glucoboy/DroneAgricole/configs/README.md

# Configurations

Paramètres partagés, profils de plateforme, calibrations de référence non sensibles et configurations de campagne.

Chaque configuration critique doit être liée à une version de matériel et porter des unités explicites.
