glucoboy/DroneAgricole/hardware/cad/cartographe_v0_1/empreintes_sources.csv

fichier | octets | sha256
Airy_3D_FOV.STEP | 8741607 | 62BF7D54AB7475F72D09EAFF1B641E6A658C45FAE5A42977667CD1F92E418BE3
Basler_ace_2_USB3.zip | 2178520 | D7F824E735B549A6CDD761DCA437656FBA1712C78CD92BFE94A426819BFCA4F4
basler_dimensions.svg | 24594 | A97F470CA227974FC0EEC72EC5B8B4EC3C7F0A1F28764435E732E62D50F45518
jetson_orin_nano_devkit.zip | 12998544 | 9F00FF9B7FC36265842E6463BEE6954350C461D4B0CD52C87AEF3872BAF8FE1C
pixhawk_5x_6x_module.stp | 1000676 | 6E0AA698FDCD1565BDC3709B92054BE0DC55AA82D951FE10B6F5B554210A477C
pixhawk6x_base_v2a.stp | 39520842 | 0610FA7762F88B5EB867647702C6A34BD2F6FE98FF04C158EFB860AD077AC11C
simpleRTK2B_PCB.PDF | 77293 | 57E04ACBD0D91F22E6FE09BE9FFCDD2ABE6DAFC2EC8DB6D04C977B0DF89C1A38
simpleRTK2B.STL | 3617784 | CD550B324E5070A756FBC59C7BB1A22EE38B8263B5B4434B89BD80D70E189C4D
x650-frame-2025-0825.stp | 25393107 | 62CF031A85C59A7F023C2B525115497DFB0821DE9C964C1A5CF905C549D156F7
basler/Basler ace 2 USB3.pdf | 192614 | E16CD2B1CA47EC81D0DC8EA953976592B4D870148079B5FCC45D91605CE7977F
basler/Basler ace 2 USB3.stp | 17116645 | C71E32C1FADA09C6EEF04587602841991BC90B03944DB6FDBA84754055CFB901
jetson/P3766-P3768SKU4-P3767ENVELOPE.stp | 74004141 | 02DAFEF626D5AC6EE029D1EAD431D6096C27C7C51FEF6B49D5189E1765FB9D2F
