glucoboy/DroneAgricole/datasets/README.md

# Datasets

Les données volumineuses ne sont pas ajoutées à Git. Seuls les manifestes, licences, checksums, adaptateurs et instructions de téléchargement sont versionnés.

Organisation prévue :

```text
datasets/
├── manifests/
├── public/
├── recorded/
└── cache/
```

Chaque dataset doit documenter sa source, sa licence, ses capteurs, ses repères, ses timestamps, ses calibrations, sa vérité terrain et son checksum.
