glucoboy/DroneAgricole/research/README.md

# Recherche

Études comparatives, notes bibliographiques, état de l'art, brevets, réglementation et résultats exploratoires.

Chaque note doit distinguer clairement faits sourcés, hypothèses de conception et décisions du projet.
