glucoboy/DroneAgricole/docs/decisions/README.md

# Décisions d'architecture (ADR)

Chaque décision structurante est décrite dans un fichier numéroté :

```text
ADR-0001-titre-court.md
```

Le document précise le contexte, la décision, les alternatives, les conséquences et le statut. Les décisions pressenties dans les documents préliminaires ne deviennent définitives qu'après validation ou création d'un ADR accepté.

## Registre

| Référence | Décision | Statut |
|---|---|---|
| ADR-0001 | Sélection initiale des datasets | accepté pour le premier benchmark |
| ADR-0002 | Séparation des environnements ROS, simulation et LIO | accepté pour le premier socle |
| ADR-0003 | Interface PX4–ROS 2 par uXRCE-DDS | accepté pour le lot A expérimental |
| ADR-0004 | Répartition des calculs entre drones et station | accepté |
| ADR-0005 | Tableau de bord comme plan de contrôle des simulations | accepté |
| ADR-0006 | C++17 et Qt 6 pour le logiciel propriétaire et l'interface desktop | accepté |
| ADR-0007 | Application desktop comme station de mission unifiée | accepté |
| ADR-0008 | Pont de télémétrie C++ entre ROS 2 Docker et Qt Windows | accepté |
| ADR-0009 | Carte 3D interactive et accumulation LiDAR bornée | accepté |
| ADR-0010 | Portefeuille de datasets pour la cartographie viticole | proposé |
| ADR-0011 | Fermeture de SW0 et qualification ARM native | accepté |
