glucoboy/DroneAgricole/hardware/electronique/cartographe/sources_fabricants/Holybro_HRTK_DroneCAN_Helical_G4_Pinout_20260930.jpg

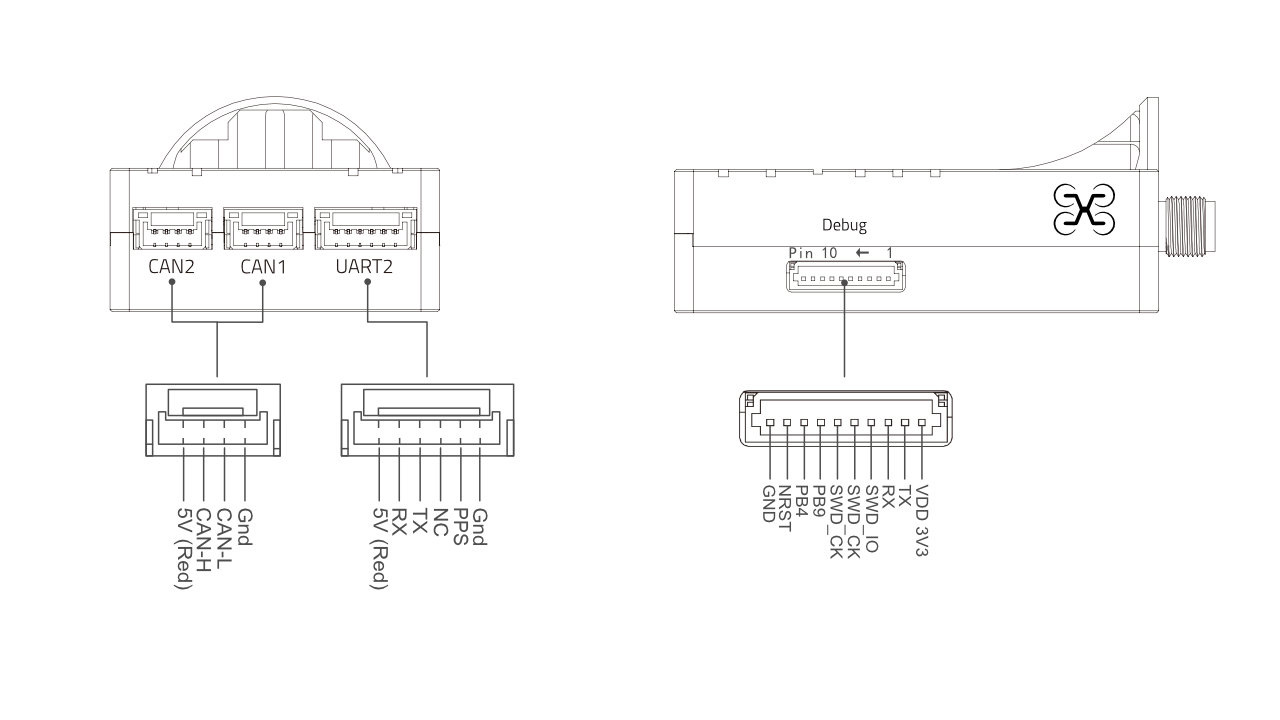
hardware/electronique/cartographe/sources_fabricants/Holybro_HRTK_DroneCAN_Helical_G4_Pinout_20260930.jpg
