glucoboy/DroneAgricole/results/README.md

# Résultats

Les résultats de benchmark et de simulation sont générés localement et ne sont pas ajoutés à Git par défaut.

Chaque exécution doit produire un manifeste permettant de retrouver : scénario, dataset, version du code, image Docker, paramètres, calibrations, machine et métriques.
