glucoboy/DroneAgricole/hardware/electronique/cartographe/carte_avionique/verification/CA01_schema_preliminaire.pdf

1 | 2 | 3 | 4 | 5 | 6

AB

C

D

AB

C

### D Date:

Size: A4 | Rev:
KiCad E.D.A. 10.0.6 | Id: 1/6

## Title:

### File: CA01_Avionique.kicad_sch

### Sheet: /

02_buck_12v_capteurs Fichier: 02_buck_12v_capteurs.kicad_sch

05_synchronisation

Fichier: 05_synchronisation.kicad_sch

03_buck_5v_aux Fichier: 03_buck_5v_aux.kicad_sch 01_energie_pm

Fichier: 01_energie_pm.kicad_sch

04_radio

Fichier: 04_radio.kicad_sch | 5V local CA01 depuis 6S protege Radio, auxiliaires et synchronisation

Budget et passifs a dimensionner LM76003 candidat 12V LiDAR / au moins 2 A cible Passifs de puissance a dimensionner GNSS PPS/GPRMC via CA01 vers Airy et Orin Pixhawk AUX1 vers Basler ; ExposureActive vers CAP1 Niveaux et chronometrie a valider CA01 - Alimentation, radio et synchronisation / CIBLE V0.5

RP4TD rapporte / UART Pixhawk Liaisons UART non montees (DNP) Niveaux et protections a valider

25/09/2026 - Migration du schema vers la cible V0.5. NON FABRICABLE. PM08-CAN, BEC1/2 et CAN hors CA01 ; 6S protege depuis PDB. Aucun courant propulsion sur cette carte. Valeurs a valider. Entree CA01 depuis XT30/PDB 6S avec protection 5V radio local ; POWER1/2 independants hors carte 12V calcul : bloc a concevoir Nets globaux : interfaces entre feuilles. Circuits physiques candidats ; protections et interfaces a valider. Les champs de puissance sont des objectifs, pas une qualification. Voir DOC-ELEC (cahier des charges) et manifest.json (limites et verifications).

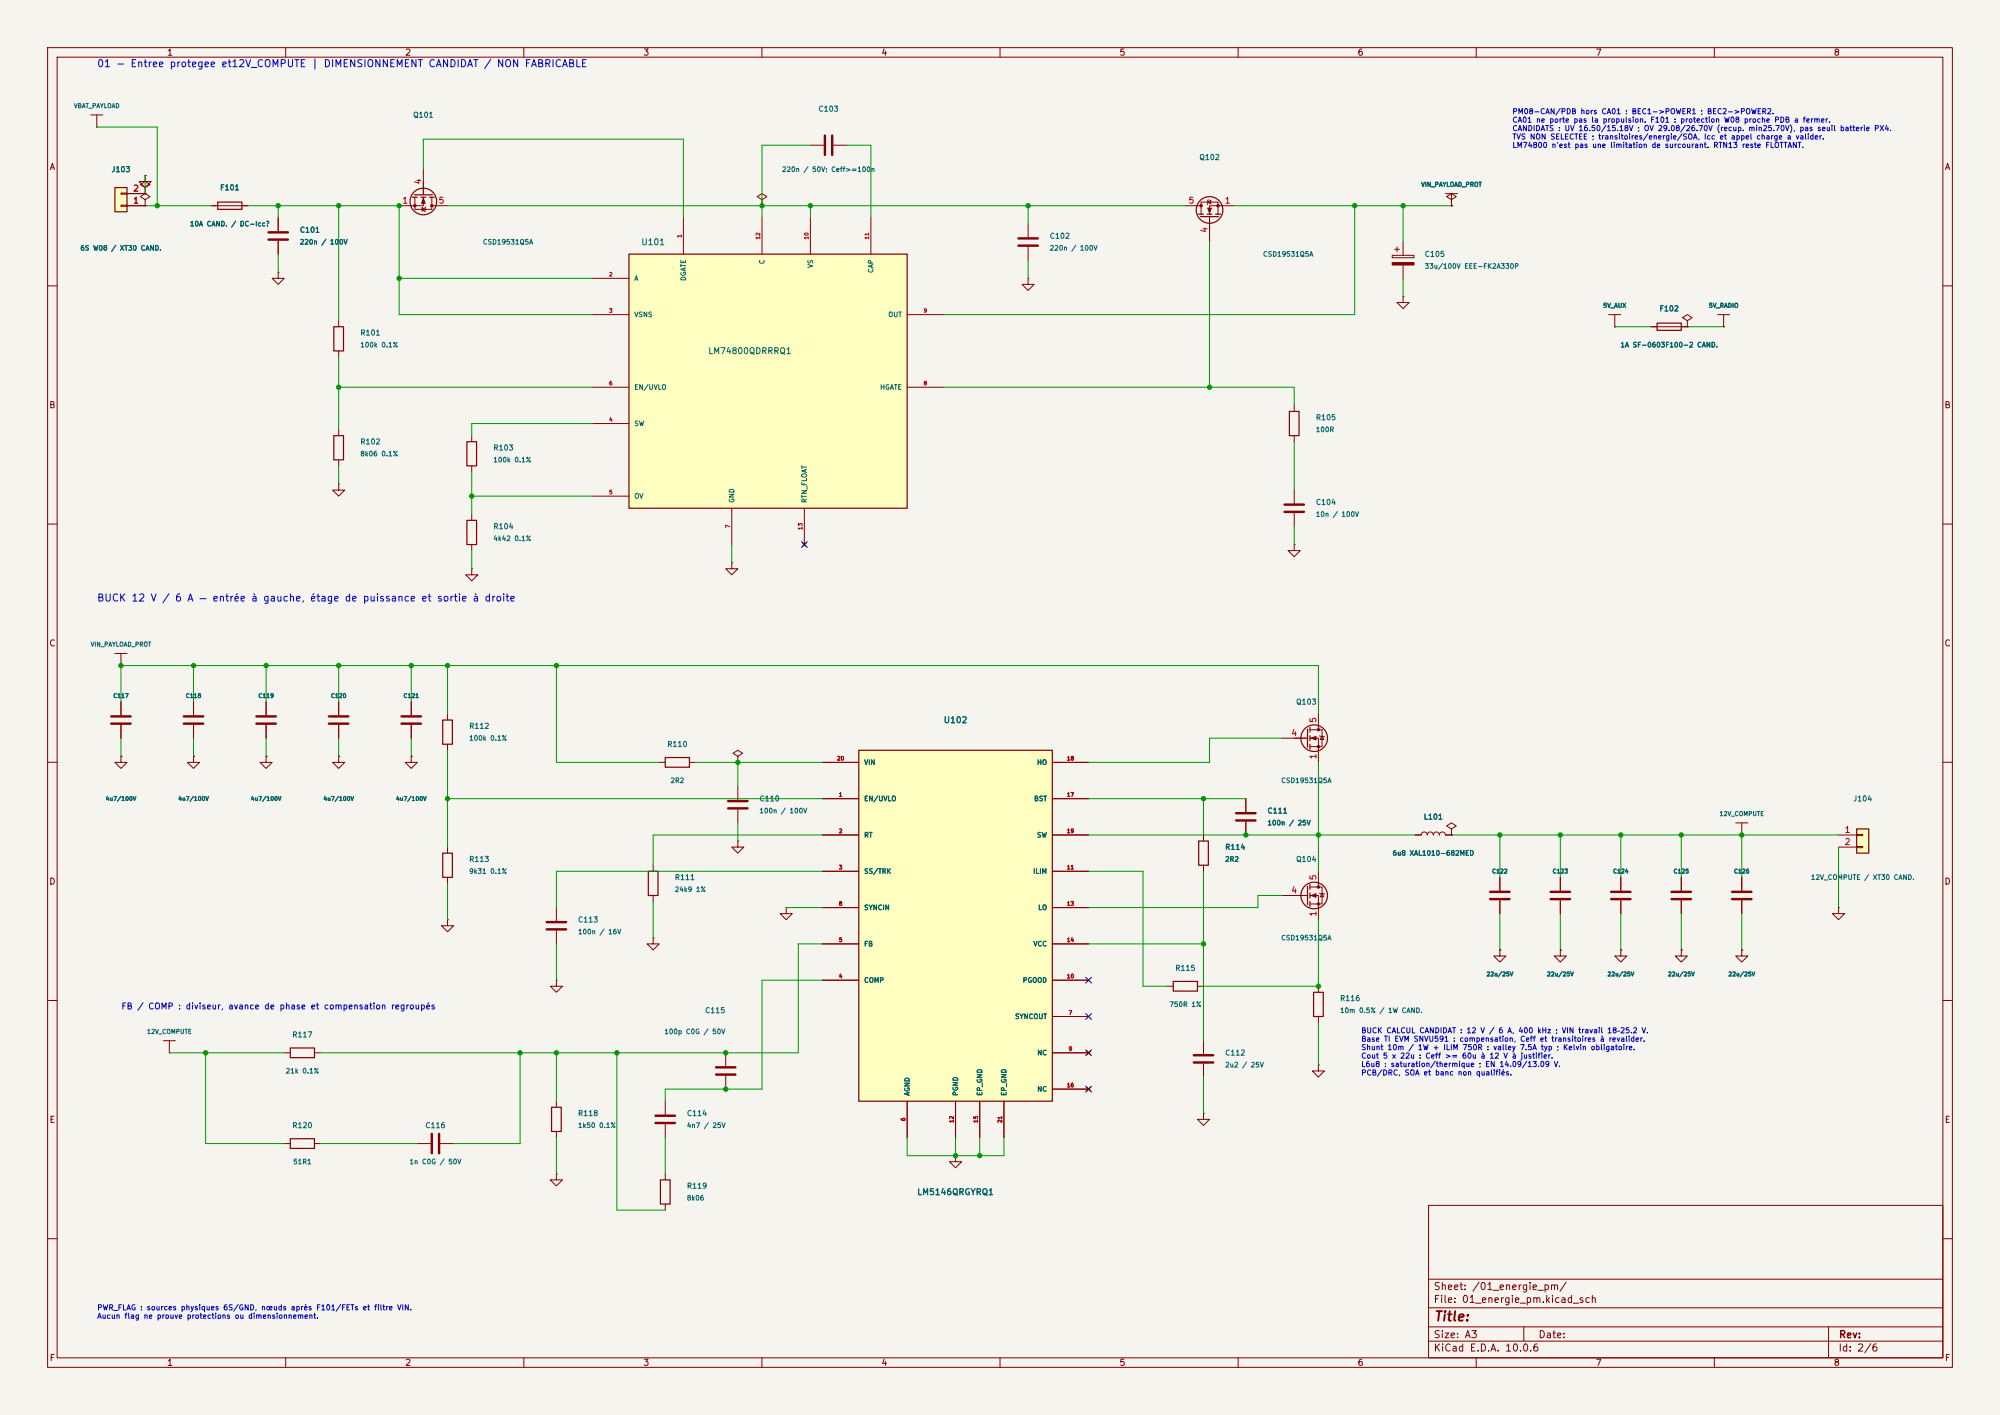
[picture p2: page 2]

PM08-CAN/PDB hors CA01 : BEC1->POWER1 ; BEC2->POWER2. CA01 ne porte pas la propulsion. F101 : protection W08 proche PDB a fermer. CANDIDATS : UV 16.50/15.18V ; OV 29.08/26.70V (recup. min25.70V), pas seuil batterie PX4. TVS NON SELECTEE ; transitoires/energie/SOA, Icc et appel charge a valider. LM74800 n'est pas une limitation de surcourant. RTN13 reste FLOTTANT. 01 - Entree protegee et12V_COMPUTE | DIMENSIONNEMENT CANDIDAT / NON FABRICABLE

7 HGATE 8 OUT 9 VS 10 CAP 11 C 12 RTN_FLOAT 13 U101

BUCK 12 V / 6 A — entrée à gauche, étage de puissance et sortie à droite

6 SYNCOUT 7 SYNCIN 8 NC 9 PGOOD 10

BUCK CALCUL CANDIDAT : 12 V / 6 A, 400 kHz ; VIN travail 18–25.2 V. Base TI EVM SNVU591 : compensation, Ceff et transitoires à revalider. Shunt 10m / 1W + ILIM 750R : valley 7.5A typ ; Kelvin obligatoire. Cout 5 x 22u : Ceff >= 60u à 12 V à justifier. L6u8 : saturation/thermique ; EN 14.09/13.09 V. PCB/DRC, SOA et banc non qualifiés. FB / COMP : diviseur, avance de phase et compensation regroupés PWR_FLAG : sources physiques 6S/GND, nœuds après F101/FETs et filtre VIN. Aucun flag ne prouve protections ou dimensionnement.

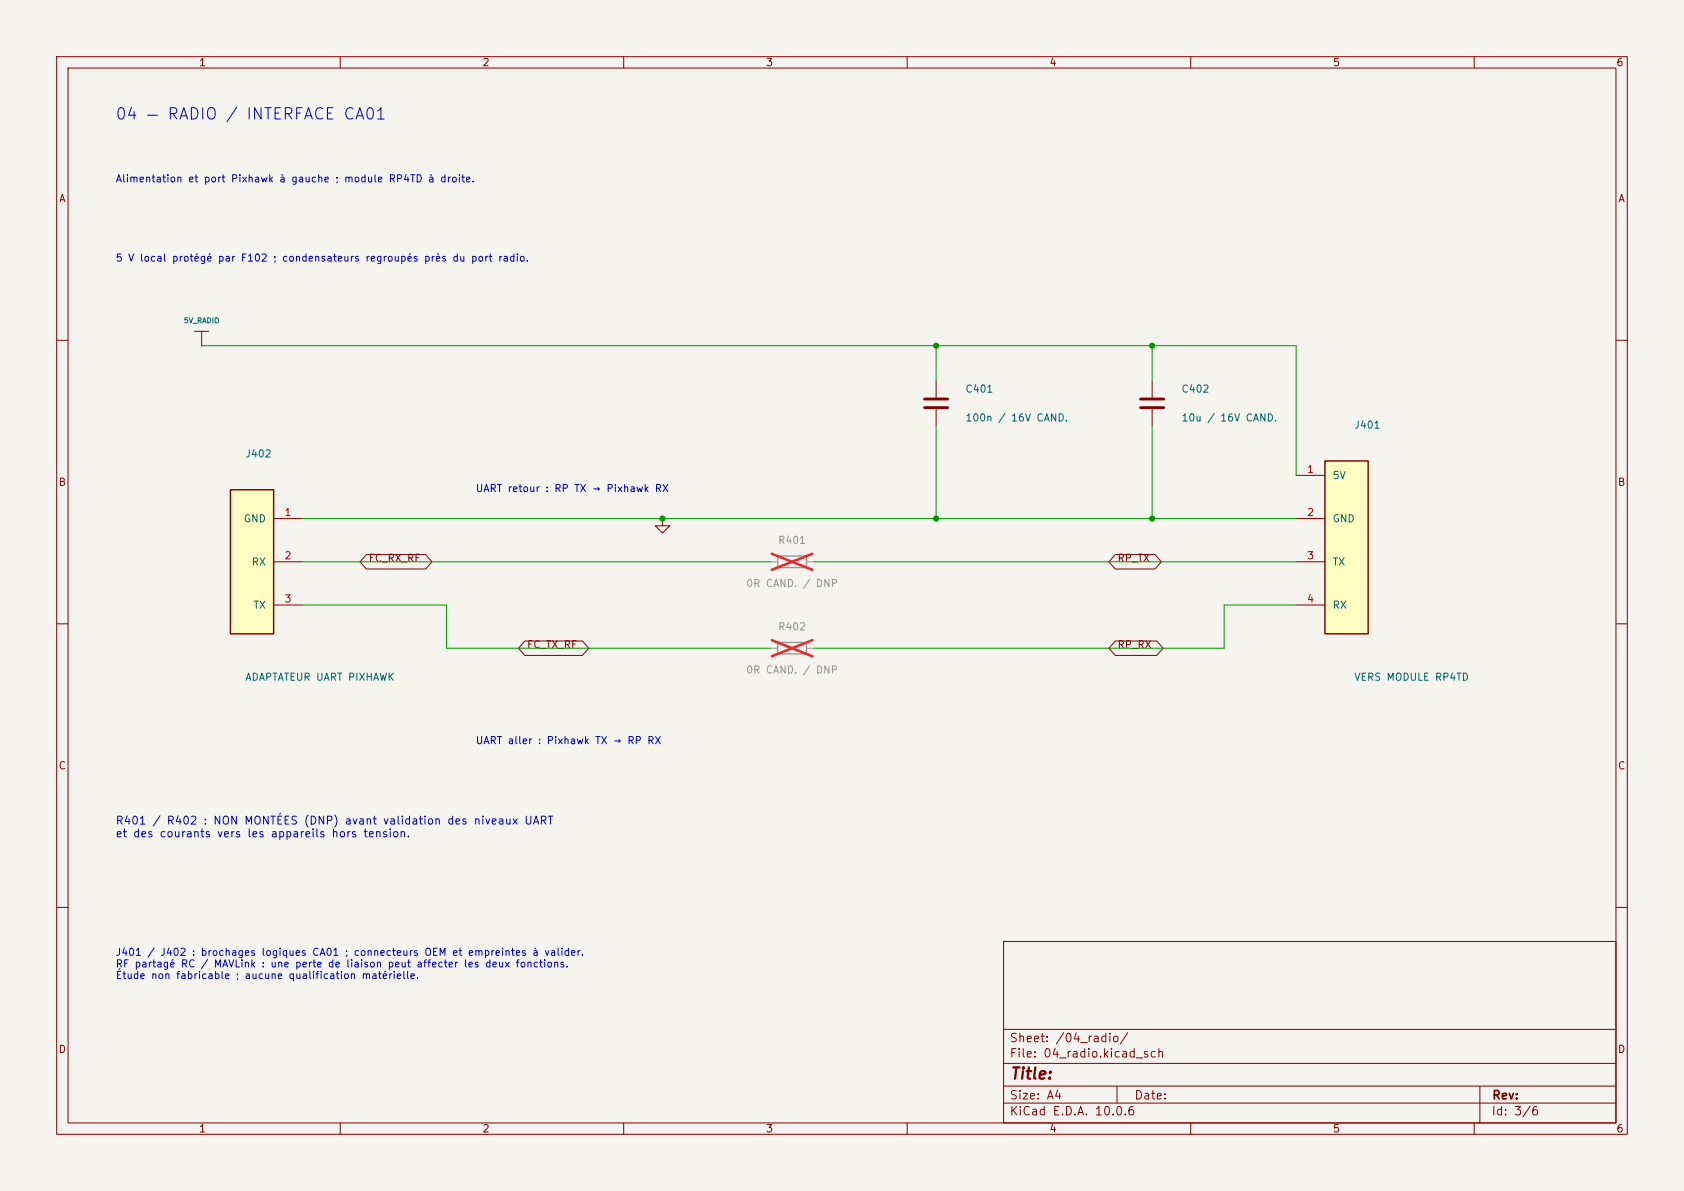
[picture p3: page 3]

Alimentation et port Pixhawk à gauche ; module RP4TD à droite. 04 — RADIO / INTERFACE CA01

5 V local protégé par F102 ; condensateurs regroupés près du port radio.

UART retour : RP TX → Pixhawk RX

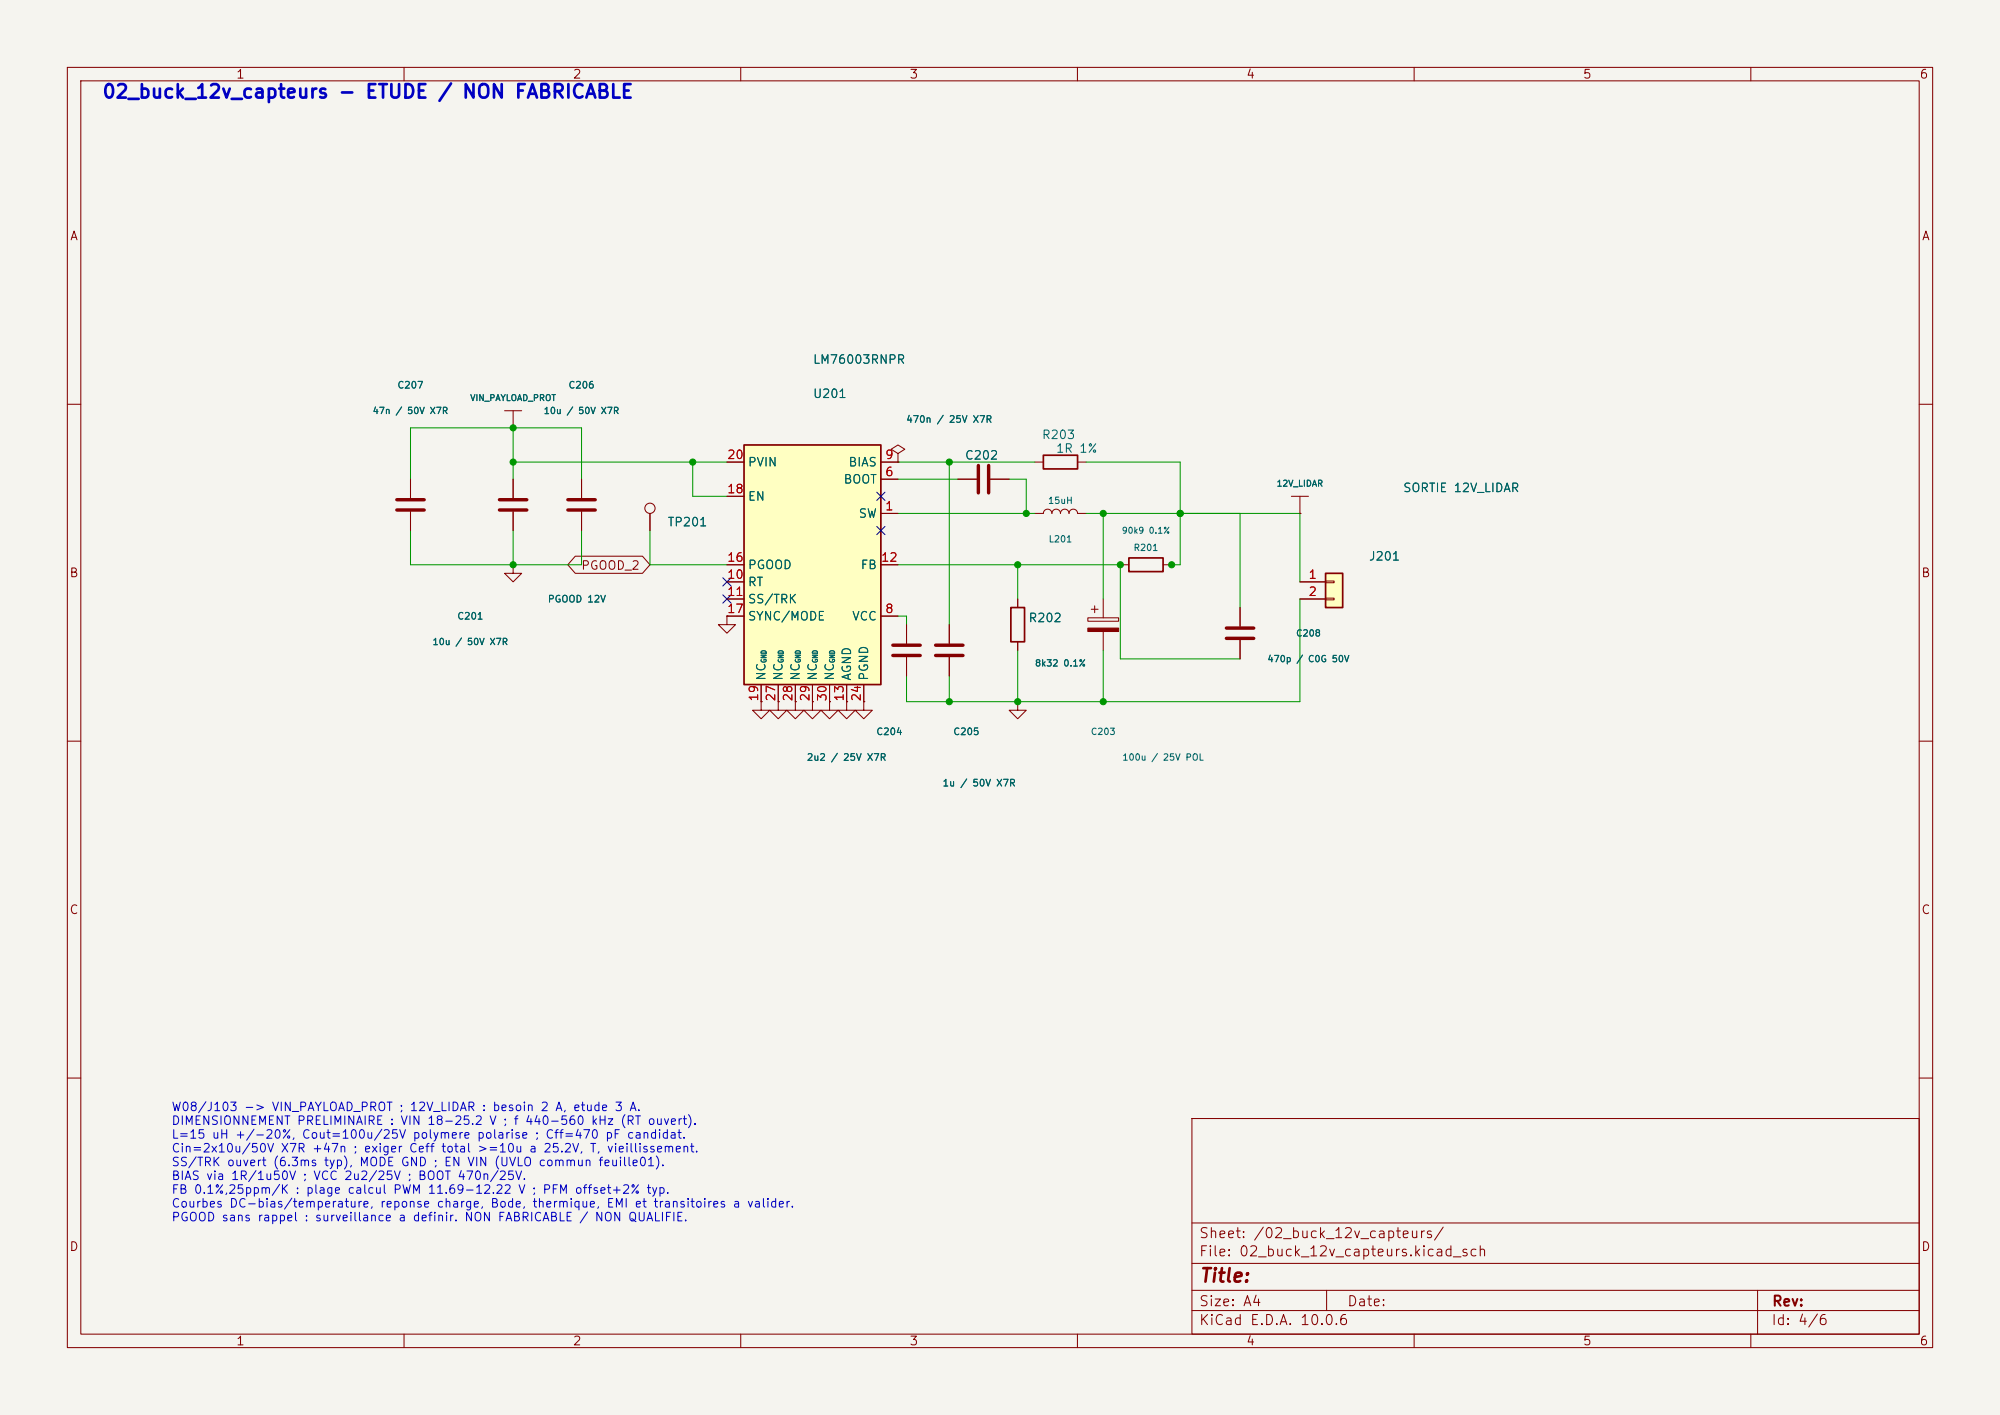
[picture p4: page 4]

W08/J103 -> VIN_PAYLOAD_PROT ; 12V_LIDAR : besoin 2 A, etude 3 A. DIMENSIONNEMENT PRELIMINAIRE : VIN 18-25.2 V ; f 440-560 kHz (RT ouvert). L=15 uH +/-20%, Cout=100u/25V polymere polarise ; Cff=470 pF candidat. Cin=2x10u/50V X7R +47n ; exiger Ceff total >=10u a 25.2V, T, vieillissement. SS/TRK ouvert (6.3ms typ), MODE GND ; EN VIN (UVLO commun feuille01). BIAS via 1R/1u50V ; VCC 2u2/25V ; BOOT 470n/25V. FB 0.1%,25ppm/K : plage calcul PWM 11.69-12.22 V ; PFM offset+2% typ. Courbes DC-bias/temperature, reponse charge, Bode, thermique, EMI et transitoires a valider. PGOOD sans rappel : surveillance a definir. NON FABRICABLE / NON QUALIFIE.

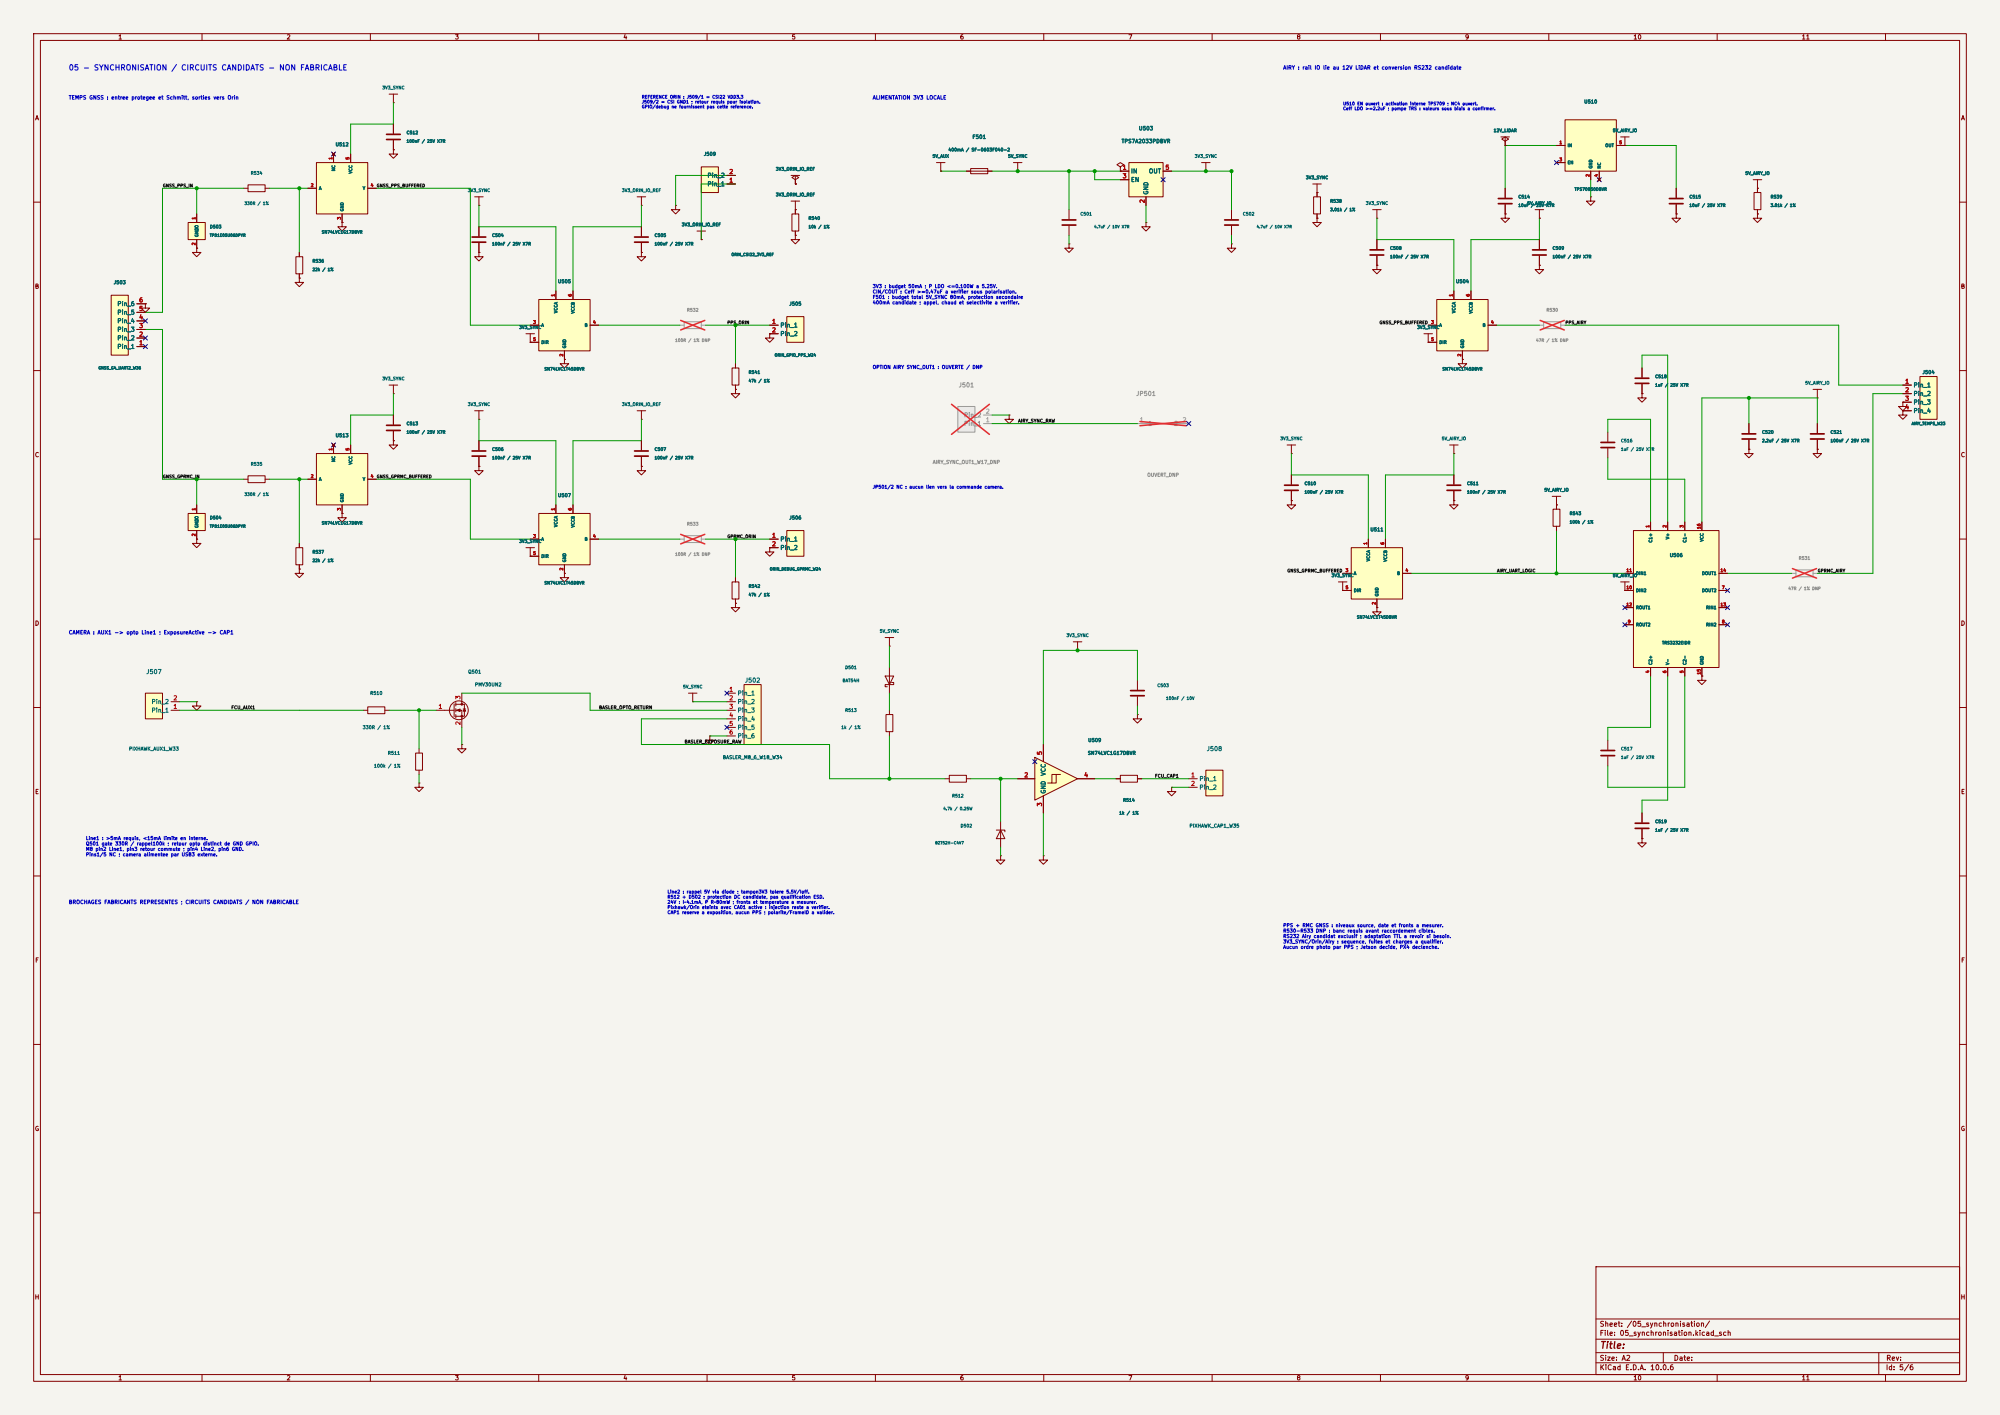
[picture p5: page 5]

U510 EN ouvert : activation interne TPS709 ; NC4 ouvert. Ceff LDO >=2.2uF ; pompe TRS : valeurs sous biais a confirmer. 3V3 : budget 50mA ; P LDO <=0.100W a 5.25V. CIN/COUT : Ceff >=0.47uF a verifier sous polarisation. F501 : budget total 5V_SYNC 80mA, protection secondaire 400mA candidate ; appel, chaud et selectivite a verifier. JP501/2 NC : aucun lien vers la commande camera.

Line1 : >5mA requis, <15mA limite en interne. Q501 gate 330R / rappel100k ; retour opto distinct de GND GPIO. M8 pin2 Line1, pin3 retour commute ; pin4 Line2, pin6 GND. Pins1/5 NC ; camera alimentee par USB3 externe.

Line2 : rappel 5V via diode ; tampon3V3 tolere 5.5V/Ioff. R512 + D502 : protection DC candidate, pas qualification ESD. 24V : I~4.1mA, P R~80mW ; fronts et temperature a mesurer. Pixhawk/Orin eteints avec CA01 active : injection reste a verifier. CAP1 reserve a exposition, aucun PPS ; polarite/FrameID a valider. BROCHAGES FABRICANTS REPRESENTES ; CIRCUITS CANDIDATS / NON FABRICABLE

PPS + RMC GNSS : niveaux source, date et fronts a mesurer. R530-R533 DNP : banc requis avant raccordement cibles. RS232 Airy candidat exclusif ; adaptation TTL a revoir si besoin. 3V3_SYNC/Orin/Airy : sequence, fuites et charges a qualifier. Aucun ordre photo par PPS ; Jetson decide, PX4 declenche.

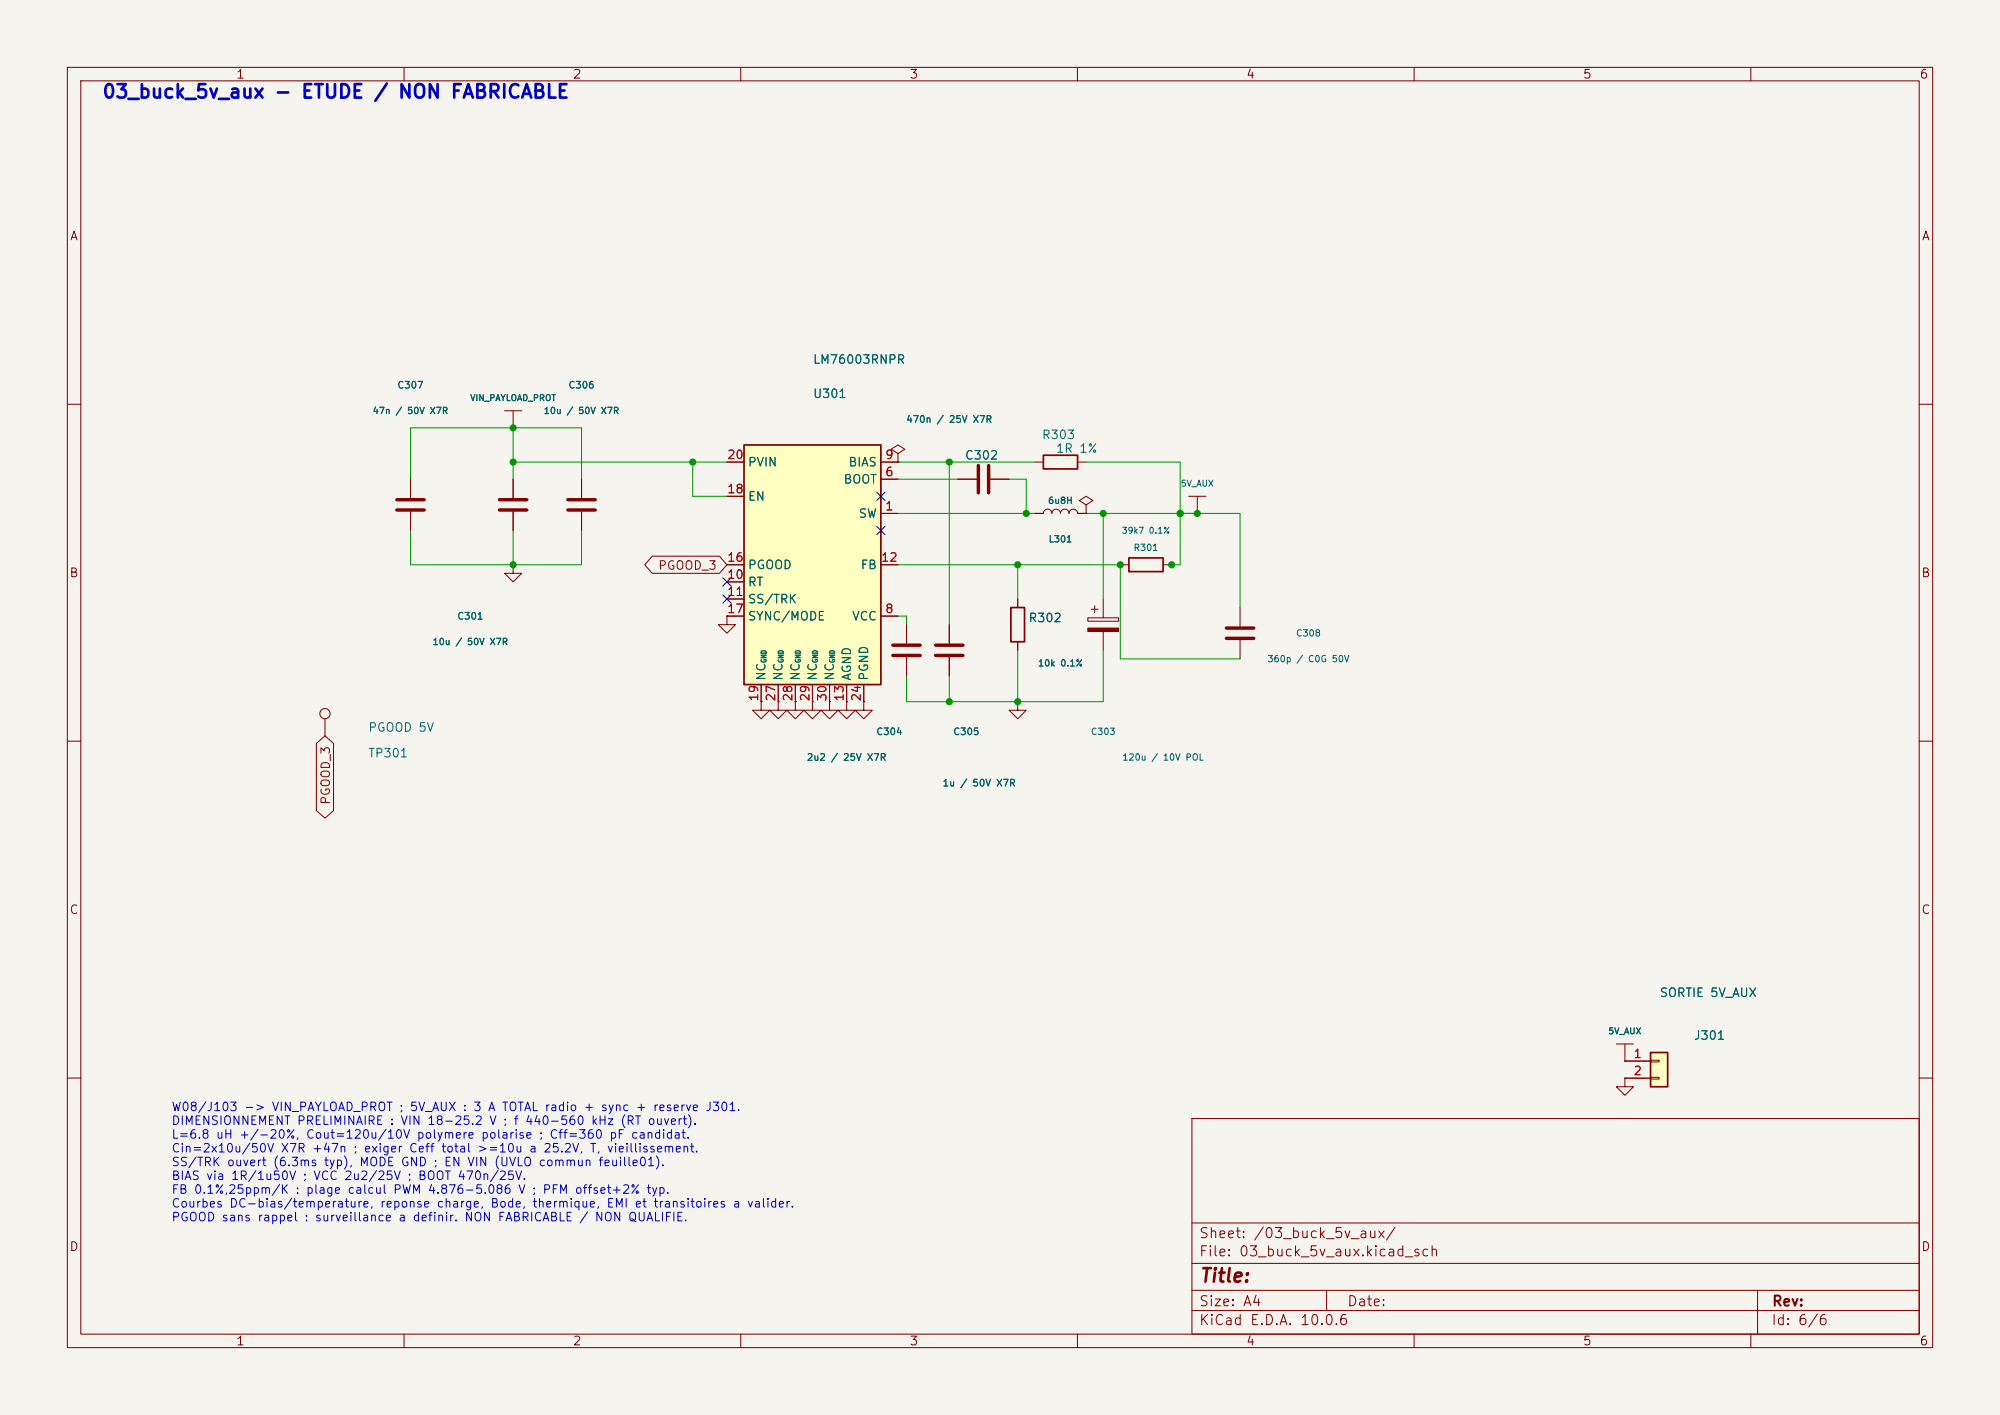
[picture p6: page 6]

W08/J103 -> VIN_PAYLOAD_PROT ; 5V_AUX : 3 A TOTAL radio + sync + reserve J301. DIMENSIONNEMENT PRELIMINAIRE : VIN 18-25.2 V ; f 440-560 kHz (RT ouvert). L=6.8 uH +/-20%, Cout=120u/10V polymere polarise ; Cff=360 pF candidat. Cin=2x10u/50V X7R +47n ; exiger Ceff total >=10u a 25.2V, T, vieillissement. SS/TRK ouvert (6.3ms typ), MODE GND ; EN VIN (UVLO commun feuille01). BIAS via 1R/1u50V ; VCC 2u2/25V ; BOOT 470n/25V. FB 0.1%,25ppm/K : plage calcul PWM 4.876-5.086 V ; PFM offset+2% typ. Courbes DC-bias/temperature, reponse charge, Bode, thermique, EMI et transitoires a valider. PGOOD sans rappel : surveillance a definir. NON FABRICABLE / NON QUALIFIE.
