glucoboy/DroneAgricole/hardware/electronique/cartographe/carte_avionique/01_energie_pm.kicad_sch

## KiCad design hardware/electronique/cartographe/carte_avionique/01_energie_pm.kicad_sch (2026-10-01, an earlier design)

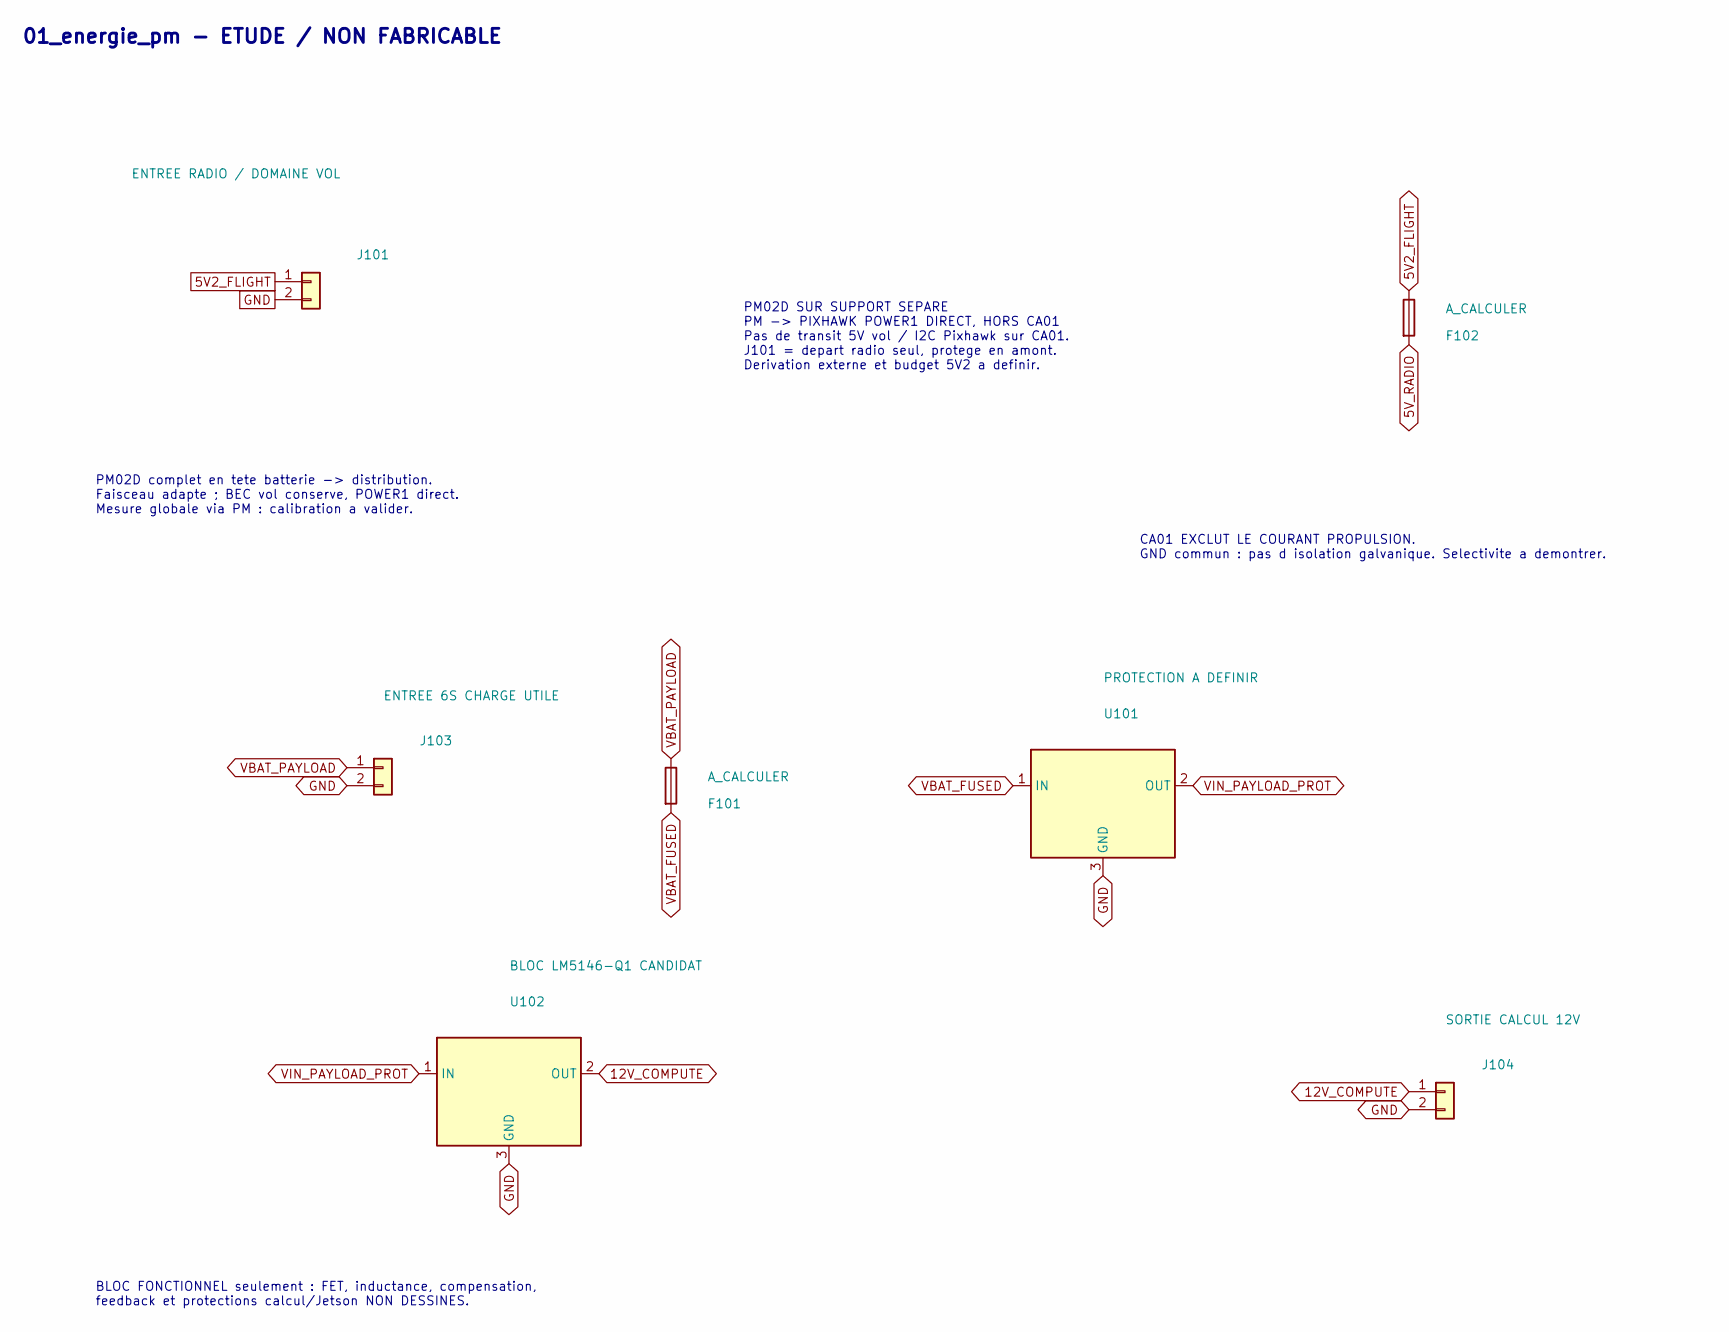
[picture p7: schematic 01_energie_pm.kicad_sch]

Parts:
F101, F102: A_CALCULER
J101: ENTREE RADIO / DOMAINE VOL
J103: ENTREE 6S CHARGE UTILE
J104: SORTIE CALCUL 12V
U101: PROTECTION A DEFINIR
U102: BLOC LM5146-Q1 CANDIDAT

Connections:
5V2_FLIGHT: F102.1, J101.1
5V_RADIO: F102.2
12V_COMPUTE: J104.1, U102.2 (OUT)
GND: J101.2, J103.2, J104.2, U101.3 (GND), U102.3 (GND)
VBAT_FUSED: F101.2, U101.1 (IN)
VBAT_PAYLOAD: F101.1, J103.1
VIN_PAYLOAD_PROT: U101.2 (OUT), U102.1 (IN)

Notes on the sheet:
PM02D complet en tete batterie -> distribution. Faisceau adapte ; BEC vol conserve, POWER1 direct. Mesure globale via PM : calibration a valider.
01_energie_pm - ETUDE / NON FABRICABLE
BLOC FONCTIONNEL seulement : FET, inductance, compensation, feedback et protections calcul/Jetson NON DESSINES.
CA01 EXCLUT LE COURANT PROPULSION. GND commun : pas d isolation galvanique. Selectivite a demontrer.
PM02D SUR SUPPORT SEPARE PM -> PIXHAWK POWER1 DIRECT, HORS CA01 Pas de transit 5V vol / I2C Pixhawk sur CA01. J101 = depart radio seul, protege en amont. Derivation externe et budget 5V2 a definir.
