glucoboy/DroneAgricole/hardware/electronique/cartographe/carte_avionique/02_buck_12v_capteurs.kicad_sch

## KiCad design hardware/electronique/cartographe/carte_avionique/02_buck_12v_capteurs.kicad_sch (2026-09-30, an earlier design)

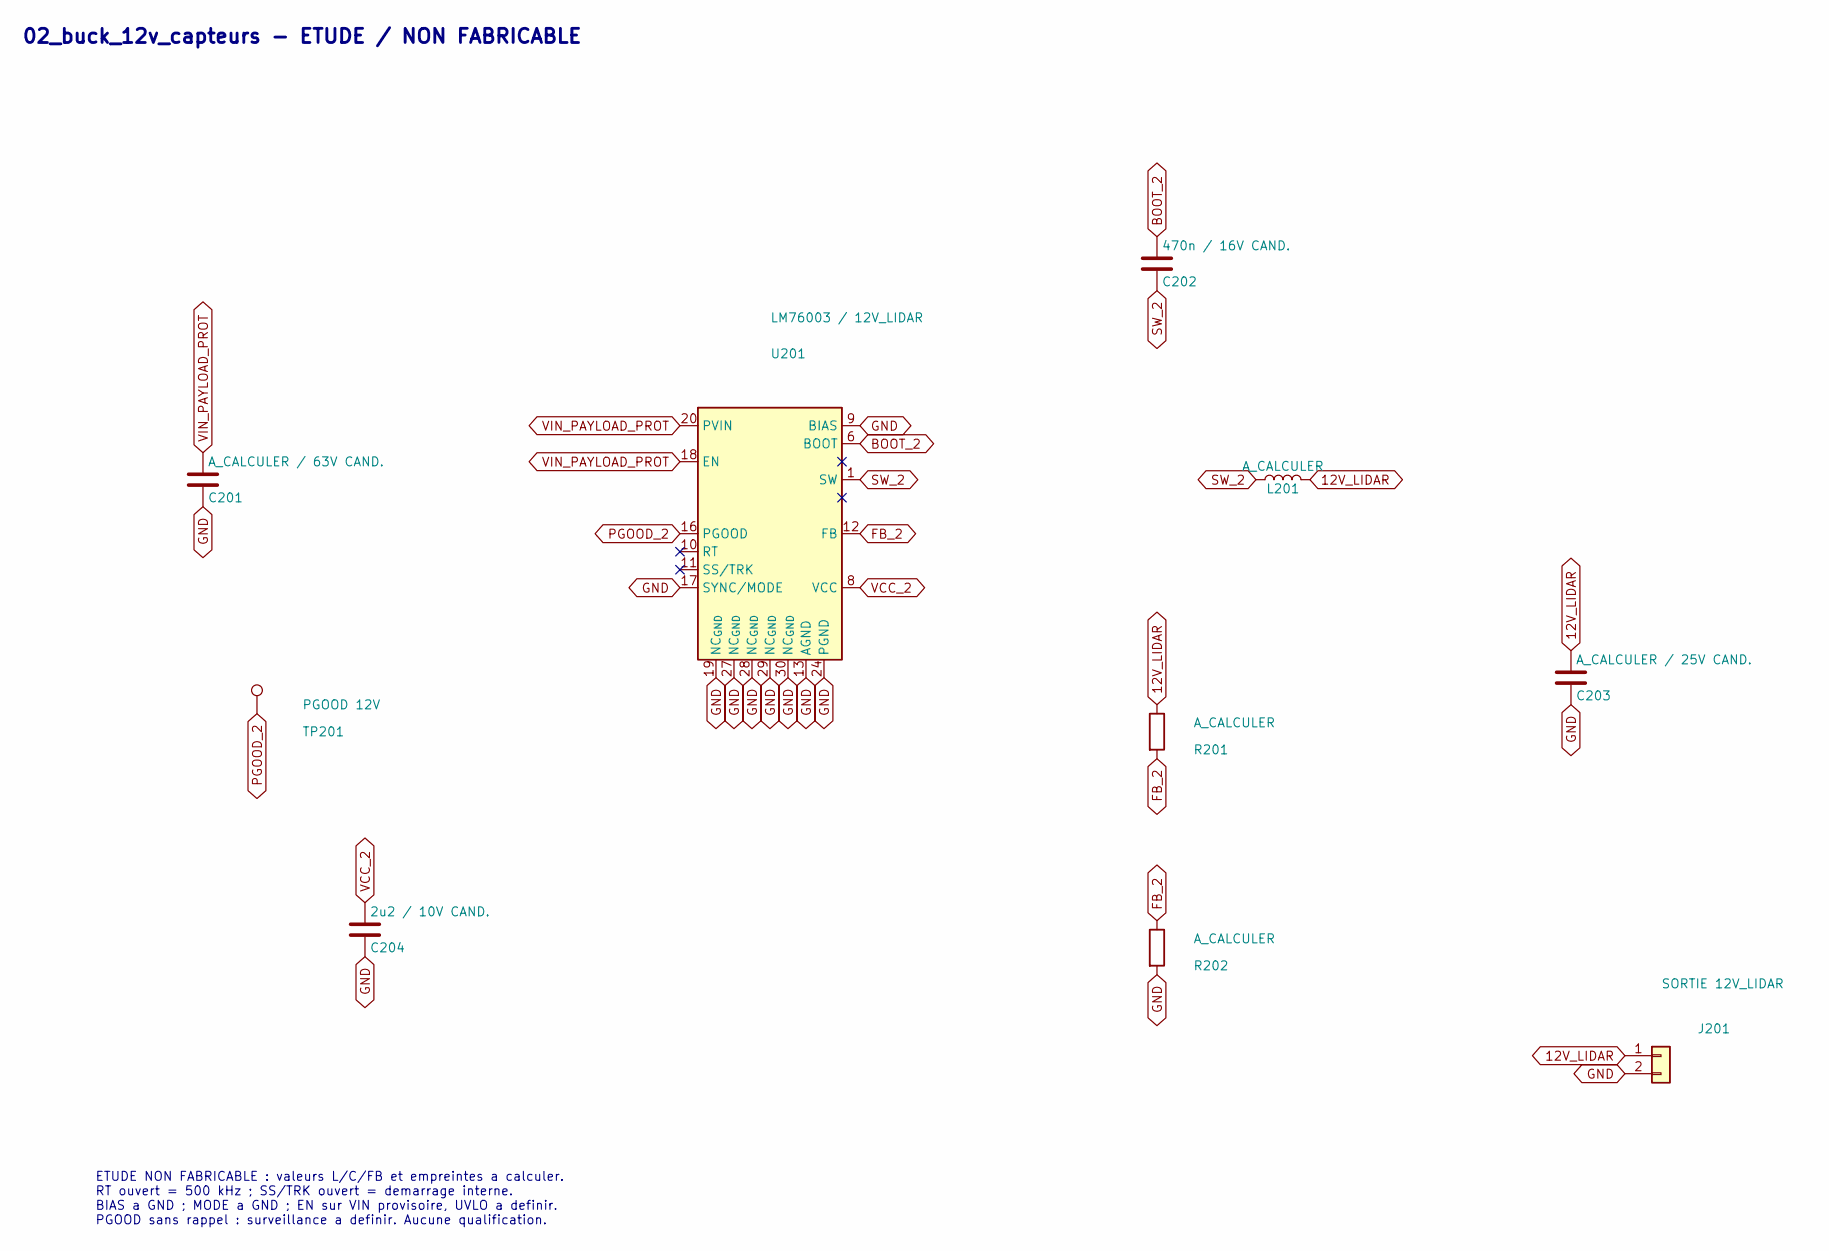
[picture p8: schematic 02_buck_12v_capteurs.kicad_sch]

Parts:
C201: A_CALCULER / 63V CAND.
C202: 470n / 16V CAND.
C203: A_CALCULER / 25V CAND.
C204: 2u2 / 10V CAND.
J201: SORTIE 12V_LIDAR
L201: A_CALCULER
R201, R202: A_CALCULER
TP201: PGOOD 12V
U201: LM76003 / 12V_LIDAR; Texas_RNP0030B_WQFN-30-1EP_4x6mm_P0.5mm_EP1.8x4.5mm_Thermal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

Connections:
12V_LIDAR: C203.1, J201.1, L201.2, R201.1
BOOT_2: C202.1, U201.6 (BOOT)
FB_2: R201.2, R202.1, U201.12 (FB)
GND: C201.2, C203.2, C204.2, J201.2, R202.2, U201.9 (BIAS), U201.13 (AGND), U201.14 (AGND), U201.15 (AGND), U201.17 (SYNC/MODE), U201.19 (NC_{GND}), U201.24 (PGND), U201.25 (PGND), U201.26 (PGND), U201.27 (NC_{GND}), U201.28 (NC_{GND}), U201.29 (NC_{GND}), U201.30 (NC_{GND}), U201.31 (AGND)
PGOOD_2: TP201.1, U201.16 (PGOOD)
SW_2: C202.2, L201.1, U201.1 (SW), U201.2 (SW), U201.3 (SW), U201.4 (SW), U201.5 (SW)
VCC_2: C204.1, U201.8 (VCC)
VIN_PAYLOAD_PROT: C201.1, U201.18 (EN), U201.20 (PVIN), U201.21 (PVIN), U201.22 (PVIN)

Notes on the sheet:
ETUDE NON FABRICABLE : valeurs L/C/FB et empreintes a calculer. RT ouvert = 500 kHz ; SS/TRK ouvert = demarrage interne. BIAS a GND ; MODE a GND ; EN sur VIN provisoire, UVLO a definir. PGOOD sans rappel : surveillance a definir. Aucune qualification.
02_buck_12v_capteurs - ETUDE / NON FABRICABLE
