glucoboy/DroneAgricole/hardware/electronique/cartographe/carte_avionique/03_buck_5v_aux.kicad_sch

## KiCad design hardware/electronique/cartographe/carte_avionique/03_buck_5v_aux.kicad_sch (2026-09-30, an earlier design)

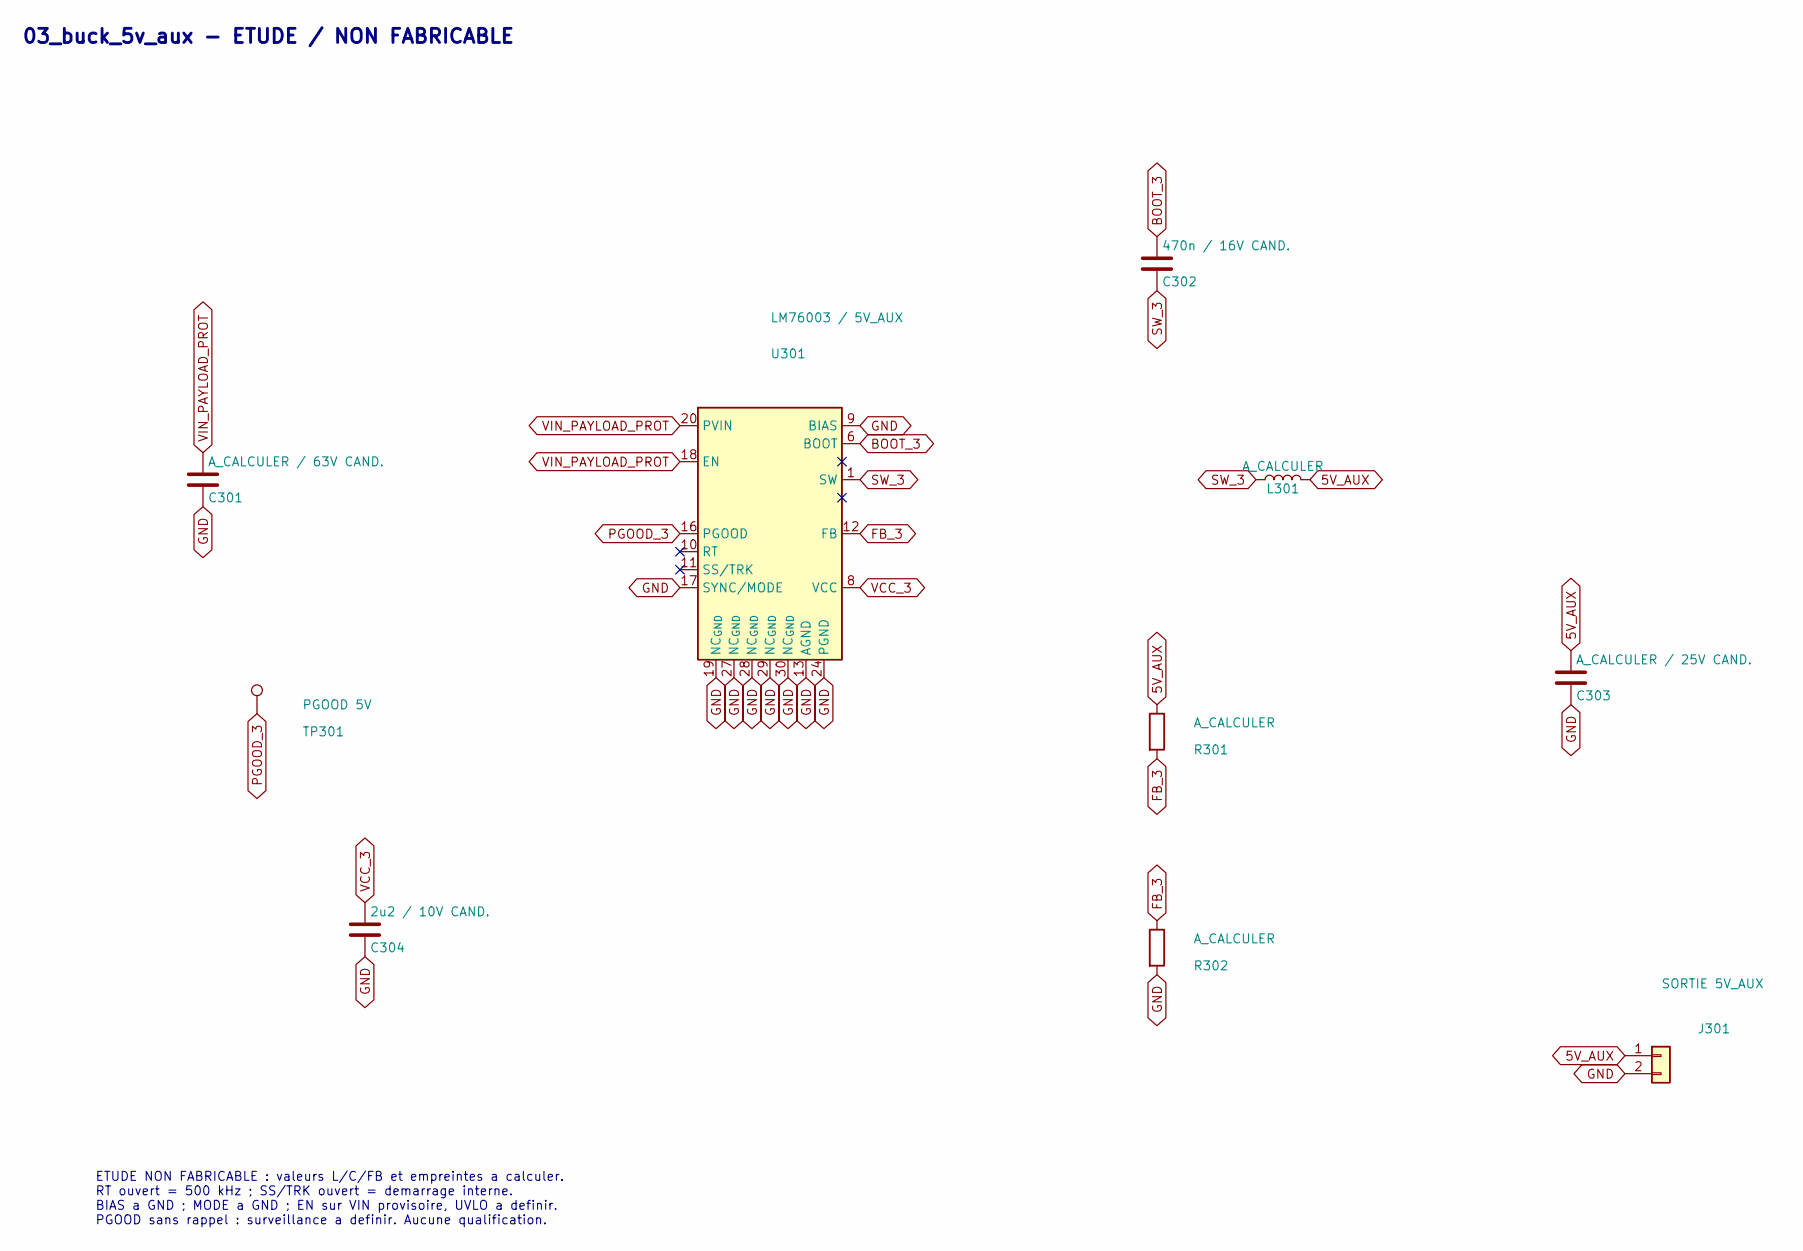
[picture p9: schematic 03_buck_5v_aux.kicad_sch]

Parts:
C301: A_CALCULER / 63V CAND.
C302: 470n / 16V CAND.
C303: A_CALCULER / 25V CAND.
C304: 2u2 / 10V CAND.
J301: SORTIE 5V_AUX
L301: A_CALCULER
R301, R302: A_CALCULER
TP301: PGOOD 5V
U301: LM76003 / 5V_AUX; Texas_RNP0030B_WQFN-30-1EP_4x6mm_P0.5mm_EP1.8x4.5mm_Thermal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

Connections:
5V_AUX: C303.1, J301.1, L301.2, R301.1
BOOT_3: C302.1, U301.6 (BOOT)
FB_3: R301.2, R302.1, U301.12 (FB)
GND: C301.2, C303.2, C304.2, J301.2, R302.2, U301.9 (BIAS), U301.13 (AGND), U301.14 (AGND), U301.15 (AGND), U301.17 (SYNC/MODE), U301.19 (NC_{GND}), U301.24 (PGND), U301.25 (PGND), U301.26 (PGND), U301.27 (NC_{GND}), U301.28 (NC_{GND}), U301.29 (NC_{GND}), U301.30 (NC_{GND}), U301.31 (AGND)
PGOOD_3: TP301.1, U301.16 (PGOOD)
SW_3: C302.2, L301.1, U301.1 (SW), U301.2 (SW), U301.3 (SW), U301.4 (SW), U301.5 (SW)
VCC_3: C304.1, U301.8 (VCC)
VIN_PAYLOAD_PROT: C301.1, U301.18 (EN), U301.20 (PVIN), U301.21 (PVIN), U301.22 (PVIN)

Notes on the sheet:
ETUDE NON FABRICABLE : valeurs L/C/FB et empreintes a calculer. RT ouvert = 500 kHz ; SS/TRK ouvert = demarrage interne. BIAS a GND ; MODE a GND ; EN sur VIN provisoire, UVLO a definir. PGOOD sans rappel : surveillance a definir. Aucune qualification.
03_buck_5v_aux - ETUDE / NON FABRICABLE
