glucoboy/DroneAgricole/hardware/electronique/cartographe/carte_avionique/04_radio.kicad_sch

## KiCad design hardware/electronique/cartographe/carte_avionique/04_radio.kicad_sch (2026-09-30, an earlier design)

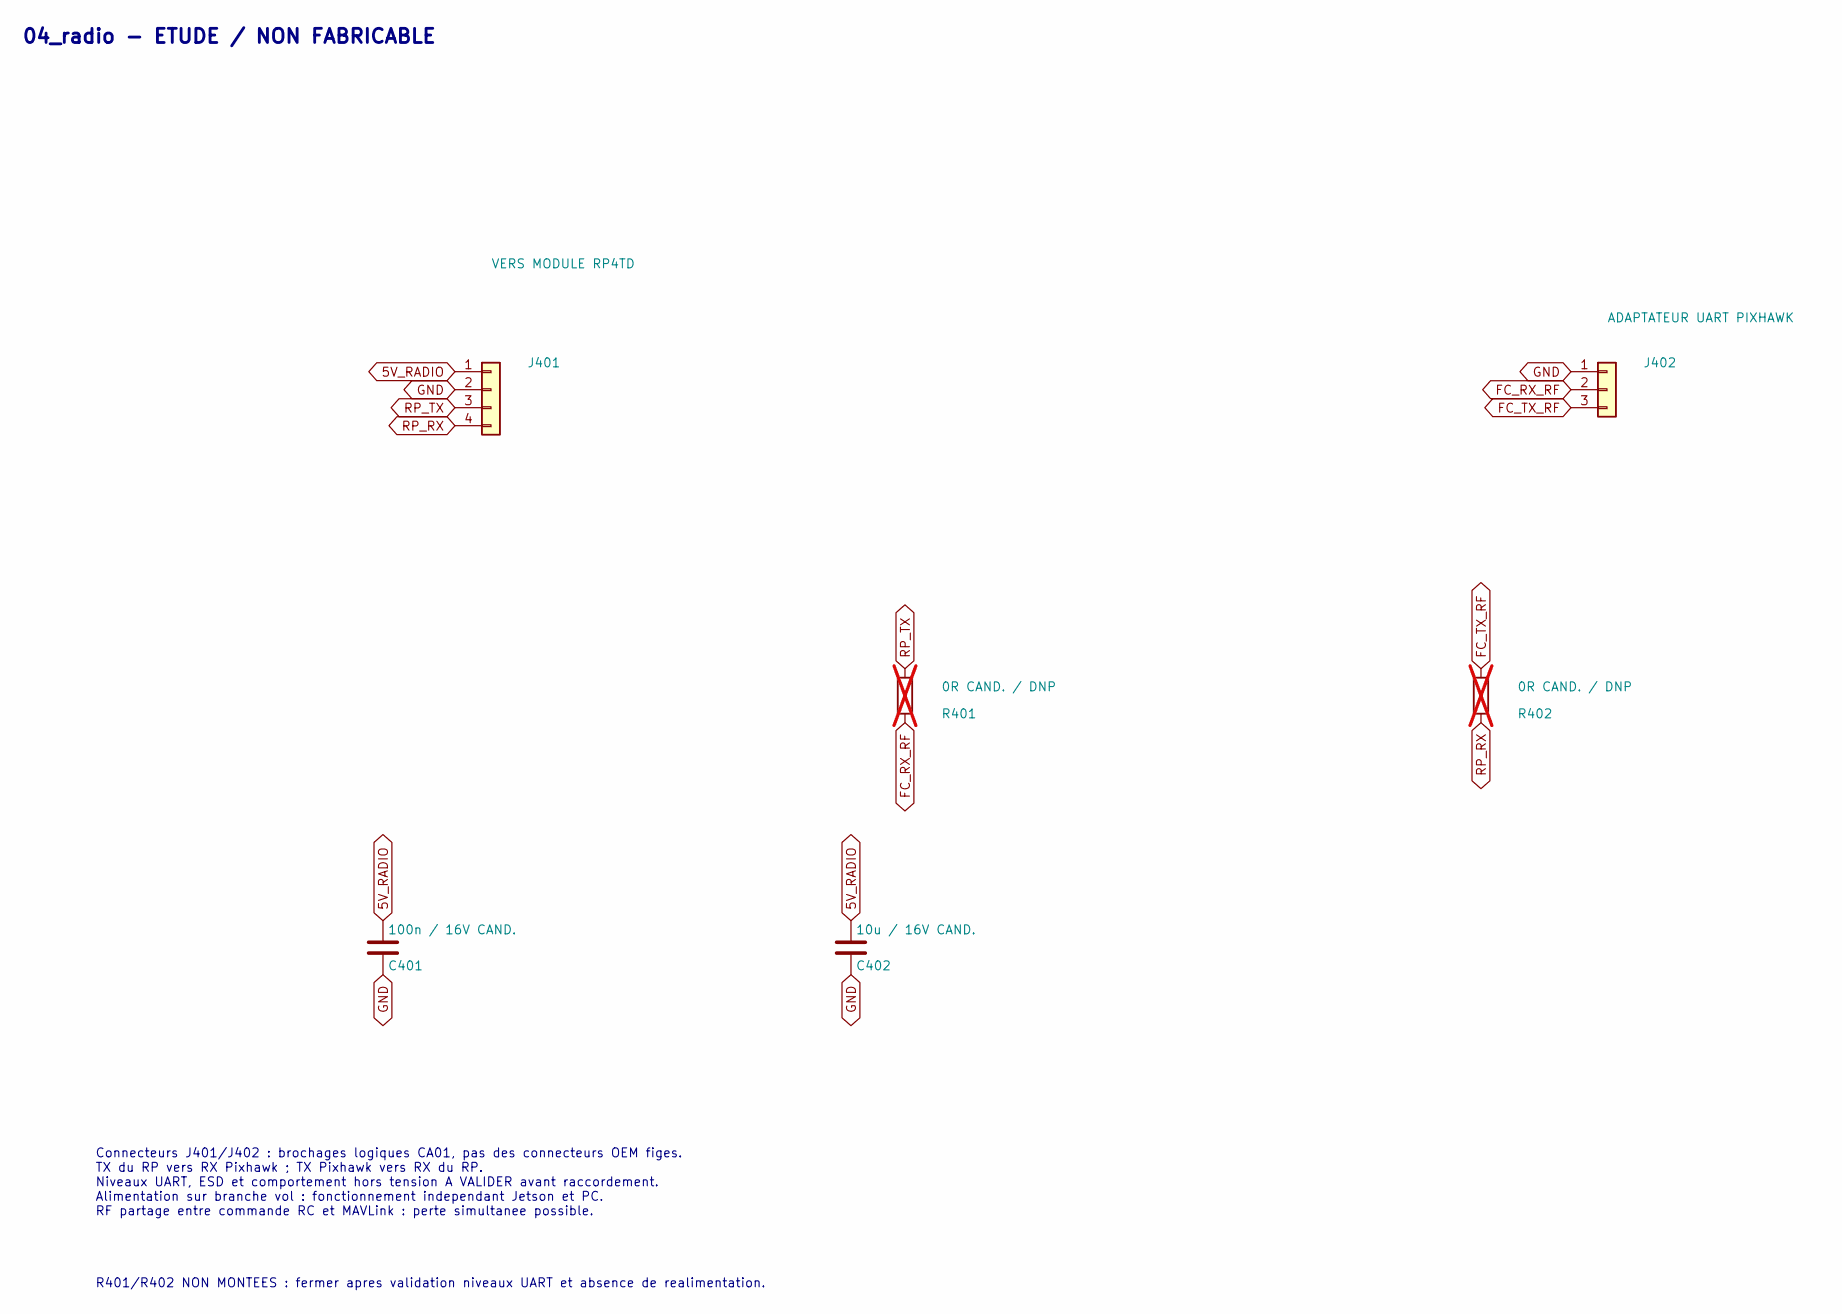
[picture p10: schematic 04_radio.kicad_sch]

Parts:
C401: 100n / 16V CAND.
C402: 10u / 16V CAND.
J401: VERS MODULE RP4TD
J402: ADAPTATEUR UART PIXHAWK
R401, R402: 0R CAND. / DNP; not fitted

Connections:
5V_RADIO: C401.1, C402.1, J401.1
FC_RX_RF: J402.2, R401.2
FC_TX_RF: J402.3, R402.1
GND: C401.2, C402.2, J401.2, J402.1
RP_RX: J401.4, R402.2
RP_TX: J401.3, R401.1

Notes on the sheet:
Connecteurs J401/J402 : brochages logiques CA01, pas des connecteurs OEM figes. TX du RP vers RX Pixhawk ; TX Pixhawk vers RX du RP. Niveaux UART, ESD et comportement hors tension A VALIDER avant raccordement. Alimentation sur branche vol : fonctionnement independant Jetson et PC. RF partage entre 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
R401/R402 NON MONTEES : fermer apres validation niveaux UART et absence de realimentation.
04_radio - ETUDE / NON FABRICABLE
