glucoboy/DroneAgricole/hardware/electronique/cartographe/carte_avionique/05_synchronisation.kicad_sch

## KiCad design hardware/electronique/cartographe/carte_avionique/05_synchronisation.kicad_sch (2026-09-30, an earlier design)

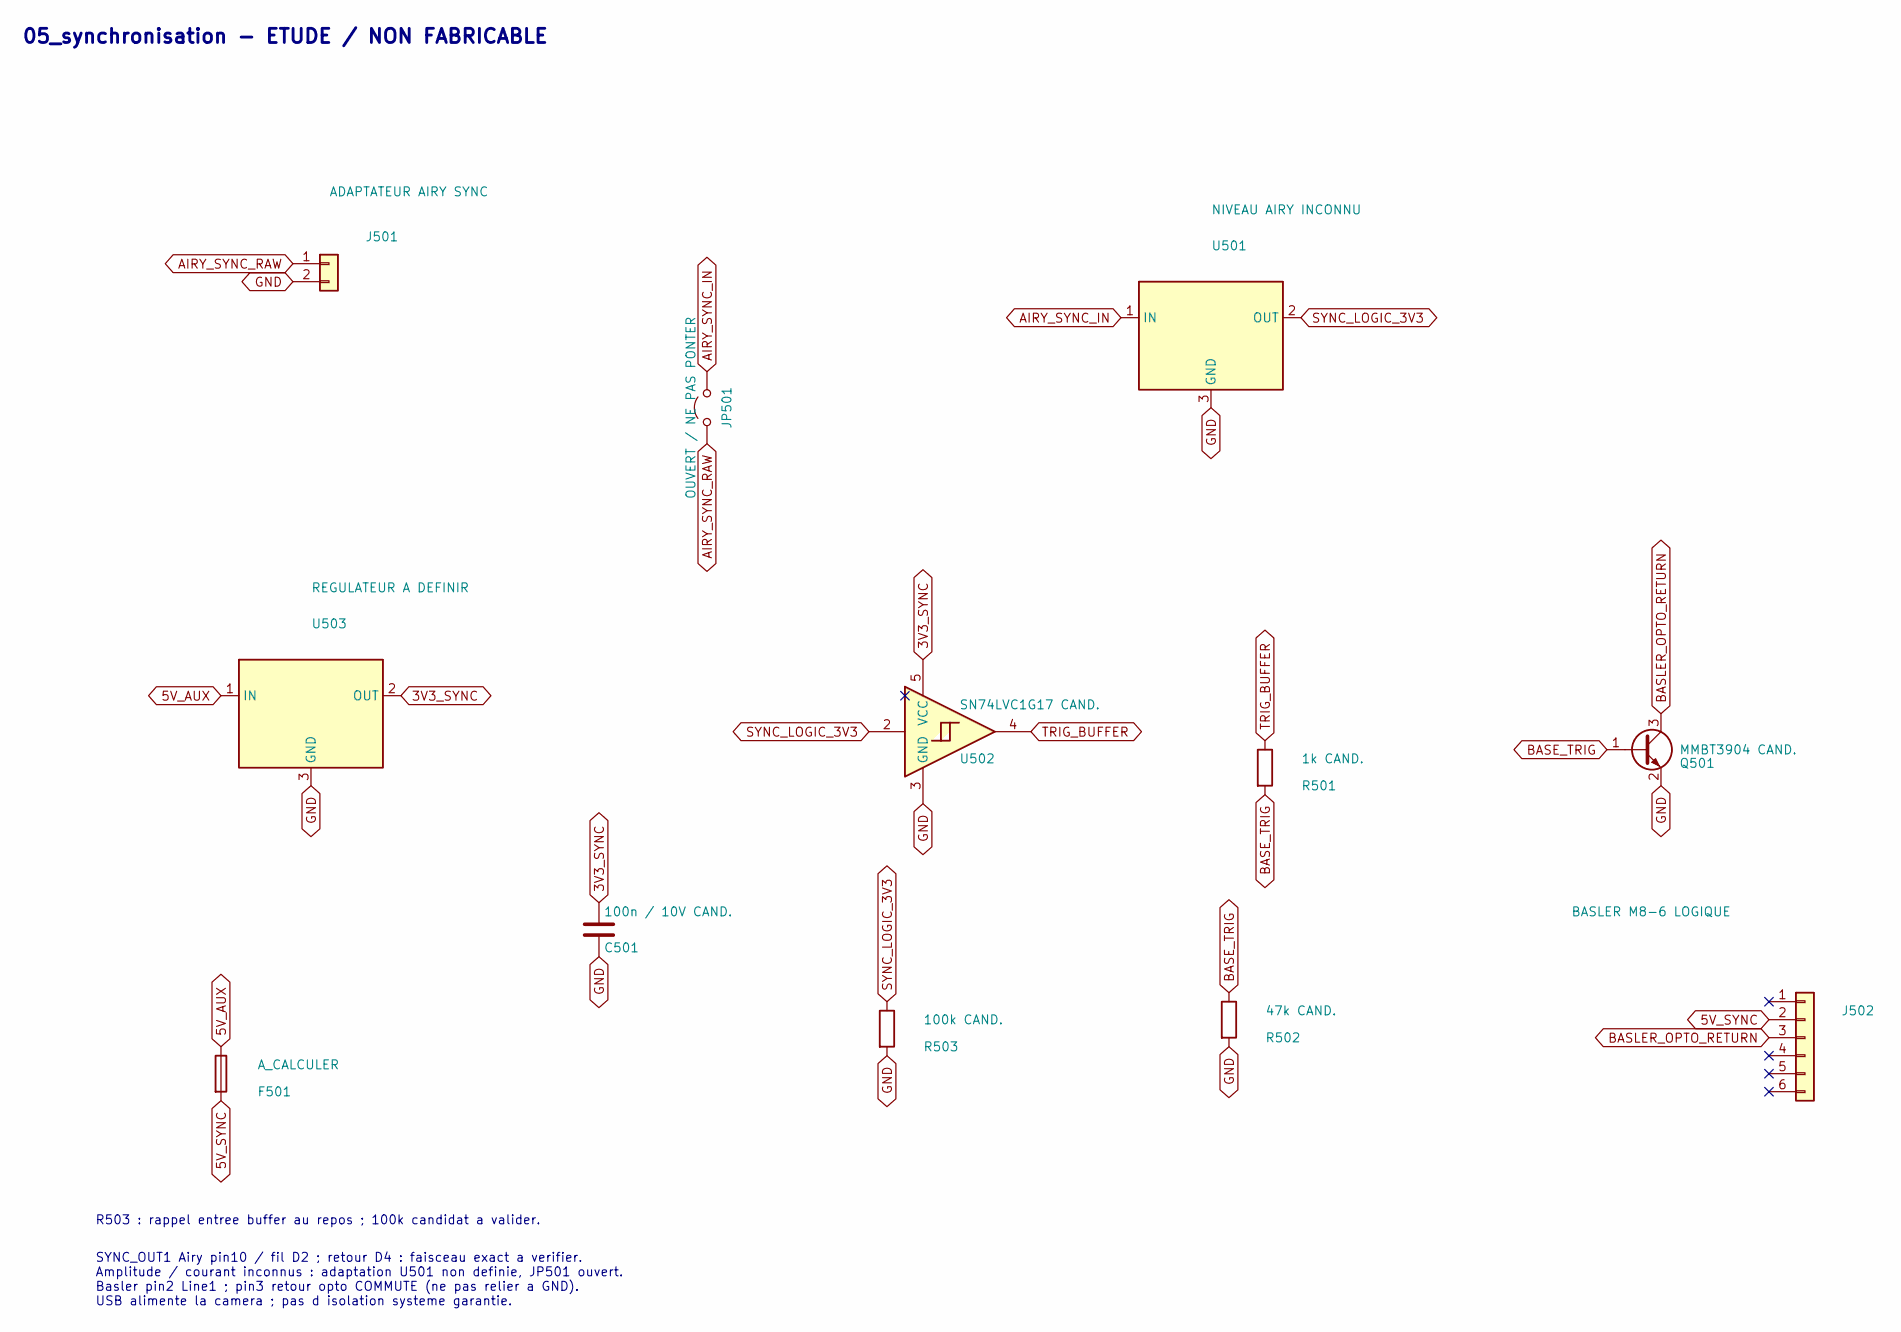
[picture p11: schematic 05_synchronisation.kicad_sch]

Parts:
C501: 100n / 10V CAND.
F501: A_CALCULER
J501: ADAPTATEUR AIRY SYNC
J502: BASLER M8-6 LOGIQUE
JP501: OUVERT / NE PAS PONTER
Q501: MMBT3904 CAND.; SOT-23
R501: 1k CAND.
R502: 47k CAND.
R503: 100k CAND.
U501: NIVEAU AIRY INCONNU
U502: SN74LVC1G17 CAND.
U503: REGULATEUR A DEFINIR

Connections:
3V3_SYNC: C501.1, U502.5 (VCC), U503.2 (OUT)
5V_AUX: F501.1, U503.1 (IN)
5V_SYNC: F501.2, J502.2
AIRY_SYNC_IN: JP501.2 (B), U501.1 (IN)
AIRY_SYNC_RAW: J501.1, JP501.1 (A)
BASE_TRIG: Q501.1 (B), R501.2, R502.1
BASLER_OPTO_RETURN: J502.3, Q501.3 (C)
GND: C501.2, J501.2, Q501.2 (E), R502.2, R503.2, U501.3 (GND), U502.3 (GND), U503.3 (GND)
SYNC_LOGIC_3V3: R503.1, U501.2 (OUT), U502.2
TRIG_BUFFER: R501.1, U502.4

Notes on the sheet:
SYNC_OUT1 Airy pin10 / fil D2 ; retour D4 : faisceau exact a verifier. Amplitude / courant inconnus : adaptation U501 non definie, JP501 ouvert. Basler pin2 Line1 ; pin3 retour opto COMMUTE (ne pas relier a GND). USB alimente la camera ; pas d isolation systeme garantie.
05_synchronisation - ETUDE / NON FABRICABLE
R503 : rappel entree buffer au repos ; 100k candidat a valider.
