glucoboy/DroneAgricole/datasets/manifests/catalogue_datasets.yaml

schema_version: 2
reviewed_on: "2026-09-07"
status: preliminary

selection_policy:
  required_for_lio_ready:
    - official_source
    - usage_terms_or_license
    - lidar_and_imu
    - calibration
    - usable_ground_truth
    - archive_size
    - archive_checksum
    - reproducible_preparation
  required_for_mapping_ready:
    - official_source
    - usage_terms_or_license
    - georeferenced_point_cloud_or_surface_model
    - horizontal_crs
    - vertical_datum_or_explicit_unknown
    - archive_size
    - archive_checksum
    - reproducible_preparation
    - independent_reference_annotations_or_annotation_plan

datasets:
  - id: botanicgarden
    priority: 1
    state: downloaded_initial_inspection_complete
    initial_sequence: "1006-03"
    initial_variant: lio_rosbag
    downloaded_on: "2026-08-18"
    size_bytes: 6326630582
    domain: natural_unstructured
    sensors: [velodyne_vlp16, livox_avia, xsens_imu, livox_imu, cameras]
    ground_truth: survey_map_localization_cm_level
    format: rosbag1
    license: academic_use_only_to_validate
    official_url: https://github.com/robot-pesg/BotanicGarden
    official_source_commit: 84c4806428ca16c154238e263a7f8bf828bf58e1
    purpose: validate_dataset_adapter_metrics_and_lio_pipeline
    local_files:
      lio_bag:
        path: datasets/public/botanicgarden/1006-03/raw/1006_03_LIO.bag
        size_bytes: 6325796540
        sha256: 482d4b3081264a6e5eaf3c05ea57d45f25cf572e01c1f887d5b598372ab79c68
      ground_truth_bag:
        path: datasets/public/botanicgarden/1006-03/ground_truth/gt_1006_03_qnew.bag
        size_bytes: 834042
        sha256: 2d507e1344da2dbb8763f96971f9d9ea902e95f7084acc903768a3f8737cf3dd
      inspection_metadata: datasets/public/botanicgarden/1006-03/inspection/bag_metadata.json
      official_calibration_archive: datasets/public/botanicgarden/1006-03/calibration/official_84c4806428ca
    calibration:
      state: inspected_with_warning
      normalized_config: configs/datasets/botanicgarden/1006-03.yaml
      report: docs/VALIDATION_QUALIFICATION.md
      warning: bmi088_camera_chain_is_not_internally_consistent_use_direct_livox_bmi088_extrinsic_for_lio
    observed:
      lio_duration_s: 610.003130001
      ground_truth_duration_s: 599.715385001
      lio_messages: 478023
      ground_truth_messages: 5947
      topics:
        - /velodyne_points
        - /odom
        - /imu/data
        - /livox/lidar
        - /livox/imu
        - /gt_poses
    readiness_notes:
      local_checksums_recorded: true
      official_checksums_available: false
      calibration_inspection: complete_with_warning
      usage_terms_validation: pending

  - id: lamole_grospoli
    priority: mapping_hard_case
    state: access_request_required
    domain: terraced_vineyard_steep_irregular
    locations: [lamole_valley, grospoli_i, grospoli_ii, castello]
    acquisition_years: [2017, 2020]
    products:
      - airborne_classified_lidar_point_cloud
      - dtm
      - dsm
      - rgb_orthophoto
      - uav_rgb_photogrammetric_point_cloud
      - uav_tir_photogrammetric_point_cloud
    raw_lidar_imu_streams: not_available_in_publications
    ground_truth: manually_traced_rows_and_walls_availability_to_validate
    format: to_validate_after_access
    license: restricted_permission_required
    official_url: https://lamolab.net/lamole-research/
    paper_url: https://doi.org/10.3390/rs13173483
    purpose: hard_case_for_terraces_walls_curved_rows_and_mapping
    blocker: exact_research_bundle_not_publicly_downloadable_permission_from_authors_and_providers_required
    assessment: docs/architecture/ARCHITECTURE_LOGICIELLE.md

  - id: escayard
    priority: mapping_quantitative_baseline
    state: b7_baseline_downloaded_initial_inspection_complete
    domain: vineyard_trellis_multimodal
    acquisition_years: [2022]
    products:
      - multispectral_orthomosaic
      - sfm_point_cloud
      - rtk_trunk_locations
      - geotagged_ground_images
      - phytosanitary_labels
    raw_lidar_imu_streams: false
    aerial_sensor: MicaSense_Altum_multispectral_and_thermal
    published_aerial_camera_products: five_band_orthomosaics_and_per_band_sfm_point_clouds
    raw_aerial_frames_and_calibrated_poses: not_listed_in_published_archive
    supported_fusion_scope: geospatial_product_level_not_temporal_lidar_camera
    ground_truth: rtk_gnss_trunk_locations
    format: geotiff_las_shapefile_csv_images
    license: CC-BY-4.0
    official_url: https://zenodo.org/records/10362568
    concept_doi: https://doi.org/10.5281/zenodo.10362567
    version_doi: https://doi.org/10.5281/zenodo.10362568
    paper_url: https://doi.org/10.1016/j.dib.2024.110497
    purpose: quantitative_row_extraction_and_geospatial_import_baseline
    initial_subset:
      - file: trunk_locations_VineyardB7.zip
        size_bytes: 8452
        md5: ada3209607dd8e01a1e6bfa9fa6143c4
        sha256: ca93f228a148069e90bcb99b4c80c497217bc327ad18292dcabdb49c29139db8
      - file: datasheet.csv
        size_bytes: 27615
        md5: f3f33215b99e9c56411d4bd43e34e310
        sha256: 7c754ecaeb8d78b37923faebf0544a8b49310a9ab4066431489edf304391a271
      - file: 20220714_FLEXIGROBOTS_B7_30M0G_MS_PRO_Green_densified_point_cloud.las
        size_bytes: 223849329
        md5: e9d08ac4c4c857a811faabcd51350bce
        sha256: 47a0ffe977becb203ecdb9253d17b639c45d9a511773d213c83361e08ebe9918
      - derived: one_B7_orthomosaic_window_later_if_required
    evaluation_policy: trunk_locations_are_evaluation_only_and_must_not_define_detection_roi
    download_recipe: tools/download_escayard.cmake
    inspection_profile: configs/datasets/escayard/B7.yaml
    inspection_report: docs/VALIDATION_QUALIFICATION.md

  - id: vinelidar
    priority: mapping_geometry_baseline
    state: public_download_ready_not_downloaded
    domain: vineyard_uav_lidar_multidate
    acquisition_years: [2021, 2022]
    products:
      - high_density_rgb_lidar_point_cloud
    raw_lidar_imu_streams: false
    ground_truth: postprocessed_rtk_georeferenced_point_cloud_no_semantic_labels
    format: laz
    license: CC-BY-4.0
    official_url: https://zenodo.org/records/8113105
    paper_url: https://doi.org/10.1016/j.dib.2023.109686
    purpose: multi_date_vineyard_geometry_and_path_planning_baseline
    initial_subset: one_B7_30m_LAZ_file_to_select

  - id: friulbot
    priority: temporal_lidar_multispectral_baseline
    state: test2_2024_07_22_downloaded_and_local_mapping_integrated
    domain: vineyard_trellis_multimodal
    platform: agilex_scout_2_ground_robot
    acquisition_date: "2024-07-22"
    sensors: [velodyne_vlp16, xsens_imu, ublox_f9p_rtk, micasense_rededge_mx, wheel_encoders]
    format: rosbag1_and_raw_multispectral_tiff
    license: CC-BY-4.0
    official_url: https://zenodo.org/records/13983719
    repository: https://github.com/diegotiozzo21/FRIULBOT_DATASET
    purpose: temporal_lidar_camera_fusion_row_mapping_and_rtk_evaluation
    initial_subset:
      - file: 2024-07-22-11-03-15.bag
        size_bytes: 6557409210
        md5: f79aac2893a0b910863962fbd9a9a2bf
      - file: 0029SET.zip
        size_bytes: 5518848615
        md5: 14ded790d1771006218fc02980ee3eb8
    observed:
      duration_s: 1283.858499272
      messages: 977318
      velodyne_scans: 12728
      imu_messages: 256812
      camera_trigger_scans: 638
      multispectral_capture_sets: 638
      tiff_files: 3190
      bands_per_capture: 5
      rosbag_chunk_compression: none
      tiff_xmp_intrinsics: present_per_band
      tiff_xmp_radiometric_calibration: present_per_band
      tiff_xmp_dls_irradiance: present_per_band
    evaluation_policy: rtk_wheel_and_published_slam_are_excluded_from_prediction_and_reserved_for_evaluation
    derived_index_bags_used_as_input: false
    download_recipe: tools/download_friulbot.cmake
    inspection_profile: configs/datasets/friulbot/test2-2024-07-22.yaml
    local_mapping_variant: vineyard_capture_mapping/trigger_rows_v1
    limitation: ground_robot_dataset_validates_perception_not_uav_flight_dynamics_or_final_sensor_geometry

  - id: newer_college
    priority: 2
    state: selected_access_form_required
    initial_sequence: "01_short_experiment"
    domain: mixed_built_open_vegetated
    sensors: [ouster_os1_64, ouster_imu, realsense_d435i]
    ground_truth: six_dof_cm_level_from_survey_map
    format: rosbag1_and_raw
    license: CC-BY-NC-SA-4.0
    official_url: https://ori-drs.github.io/newer-college-dataset/
    download_url: https://ori-drs.github.io/newer-college-dataset/download/
    purpose: reference_lio_slam_benchmark

  - id: ard_vo
    priority: 3
    state: selected_metadata_and_license_check_required
    initial_sequence: null
    sequence_filter: vineyard_with_lidar_imu_rtk_and_calibration
    domain: vineyard_and_olive_grove
    sensors: [velodyne_lidar, imu, gps_rtk, stereo_rgb, multispectral]
    ground_truth: rtk_to_validate_per_sequence
    format: to_validate
    license: unknown_to_validate
    official_url: https://isar.unipg.it/datasets/
    paper_url: https://onlinelibrary.wiley.com/doi/10.1002/rob.22179
    purpose: vineyard_lio_and_rtk_evaluation

  - id: blt
    priority: 4
    state: selected_access_form_required
    initial_sequences:
      - early_season_march_or_april
      - dense_foliage_june
    domain: vineyard_trellis_long_term
    sensors: [ouster_os1, imu, rgbd, lidar_2d, rtk_gnss]
    ground_truth: rtk_gnss
    format: rosbag1
    license: unknown_to_validate
    official_url: https://lcas.lincoln.ac.uk/wp/research/data-sets-software/blt/
    purpose: seasonal_change_loop_closure_and_dense_vegetation

  - id: tempo_vine
    priority: future_primary
    state: pending_release
    domain: vineyard_trellis_and_pergola_multiseason
    sensors: [velodyne_vlp16, livox_mid360, rgbd, ahrs_imu, rtk_gps, wheel_odometry]
    ground_truth: rtk_based_trajectory
    format: mcap_zstd
    license: unknown_to_validate
    paper_url: https://arxiv.org/abs/2512.04772
    purpose: target_domain_primary_benchmark
    blocker: no_official_download_page_identified_on_2026_08_18

  - id: m2dgr
    priority: deferred
    state: catalogue_only
    domain: indoor_outdoor_urban
    sensors: [velodyne_vlp32c, imu, gnss, rtk_ins, cameras, event, thermal]
    ground_truth: motion_capture_laser_tracker_or_rtk
    total_size_approx_tb: 1.0
    format: rosbag1
    license: repository_mit_and_academic_wording_to_validate
    official_url: https://github.com/SJTU-ViSYS/M2DGR
    purpose: later_gnss_lio_fusion_stress_test

  - id: hilti_slam
    priority: deferred
    state: catalogue_only
    domain: construction_sites
    sensors: [lidar, imu, cameras]
    ground_truth: millimeter_level_sparse
    format: rosbag
    license: to_validate
    paper_url: https://arxiv.org/abs/2109.11316
    purpose: later_lio_robustness_stress_test
