glucoboy/DroneAgricole/configs/lio/point_lio/friulbot_velodyne_xsens_visual.yaml

/**:
  ros__parameters:
    odom_only: false
    odom_header_frame_id: "camera_init"
    odom_child_frame_id: "aft_mapped"
    prop_at_freq_of_imu: true
    use_imu_as_input: true
    check_satu: true
    init_map_size: 100
    space_down_sample: true
    point_filter_num: 4
    filter_size_surf: 0.35
    filter_size_map: 0.35
    cube_side_length: 1000.0
    runtime_pos_log_enable: false
    common:
      lid_topic: "/velodyne_points"
      imu_topic: "/imu/data"
      con_frame: false
      con_frame_num: 1
      cut_frame: false
      cut_frame_time_interval: 0.1
      time_lag_imu_to_lidar: 0.0
      lidar_qos_depth: 100
      lidar_qos_reliable: true
    preprocess:
      lidar_type: 2
      scan_line: 16
      scan_rate: 10
      timestamp_unit: 0
      blind: 0.8
    mapping:
      imu_en: true
      start_in_aggressive_motion: false
      extrinsic_est_en: false
      imu_time_inte: 0.005
      satu_acc: 30.0
      satu_gyro: 35.0
      acc_norm: 9.81
      lidar_meas_cov: 0.01
      acc_cov_output: 500.0
      gyr_cov_output: 1000.0
      b_acc_cov: 0.0001
      b_gyr_cov: 0.0001
      imu_meas_acc_cov: 0.1
      imu_meas_omg_cov: 0.1
      gyr_cov_input: 0.01
      acc_cov_input: 0.1
      vel_cov: 20.0
      plane_thr: 0.1
      match_s: 81.0
      fov_degree: 180.0
      det_range: 80.0
      gravity_align: true
      gravity: [0.0, 0.0, -9.81]
      gravity_init: [0.0, 0.0, -9.81]
      extrinsic_T: [-0.0396, 0.0077, 0.04906]
      extrinsic_R: [1.0, 0.0, 0.0,
                    0.0, 1.0, 0.0,
                    0.0, 0.0, 1.0]
    odometry:
      publish_odometry_without_downsample: false
    publish:
      path_en: true
      scan_publish_en: true
      scan_bodyframe_pub_en: false
    pcd_save:
      pcd_save_en: false
      interval: -1
