glucoboy/DroneAgricole/(commit log)

2026-09-04 refactor: migrer la station et les outils en C++17 Qt6
2026-09-04 build: consolider Docker Compose et la CI SW0
2026-09-04 docs: aligner l architecture et les guides C++17 Qt6
2026-09-04 docs: ajouter l étude candidate de cartographie viticole
2026-09-05 fix: fiabiliser l alignement ATE des trajectoires planes
2026-09-05 build: borner aussi le parallelisme du noyau et de Qt
2026-09-05 fix: stabiliser la mesure des petits angles sous Qt 6.2
2026-09-05 docs: fermer SW0 et tracer les qualifications restantes
2026-09-30 feat(hw): compléter CA01 et clarifier la synchronisation des captures
2026-10-01 docs(hw): publier le schéma CA01 en PDF à côté du projet KiCad
2026-10-01 Améliore la lisibilité du LM74800 et actualise le PDF CA01
